saman-fuyal/fpga-audio-filter/docs/photos/setup_raw.jpg

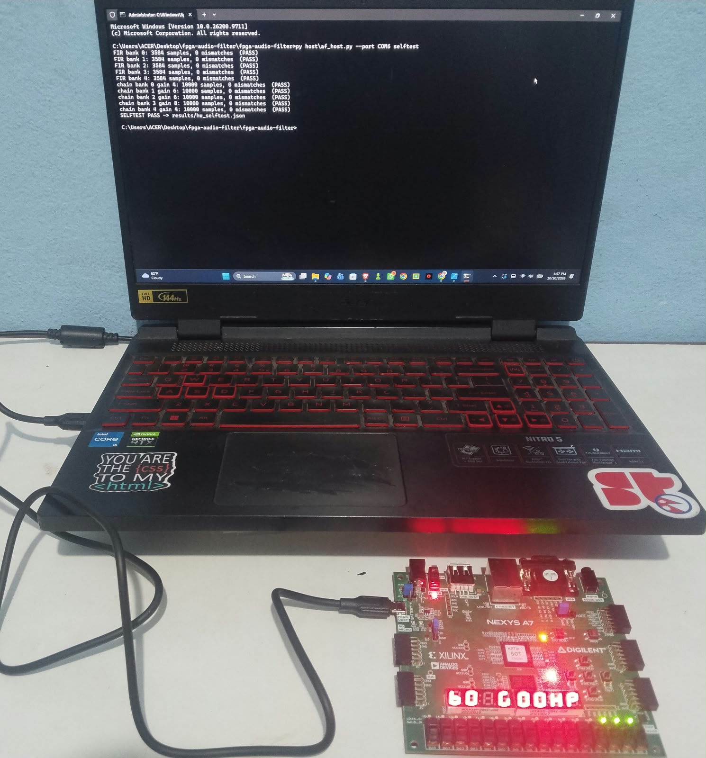
docs/photos/setup_raw.jpg
