saman-fuyal/fpga-audio-filter/docs/photos/setup_labelled.jpg

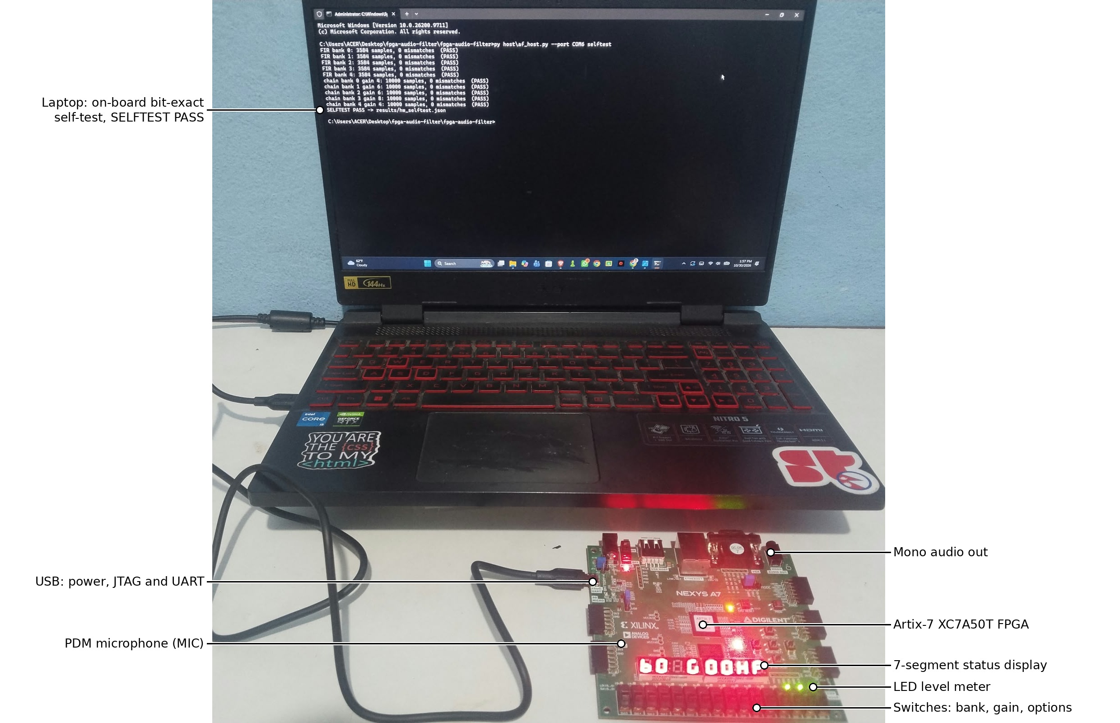
docs/photos/setup_labelled.jpg
