saman-fuyal/fpga-audio-filter/docs/report/figs_src/common.tex

\usepackage[T1]{fontenc}
\usepackage{mathptmx}
\usepackage{tikz}
\usetikzlibrary{arrows.meta,positioning,fit,calc,shapes.geometric,backgrounds}
\usepackage{siunitx}
\tikzset{
  >={Stealth[length=1.8mm]},
  blk/.style={draw, thick, minimum height=11mm, text width=16mm, align=center, font=\scriptsize, inner sep=1.5pt, fill=white},
  lab/.style={font=\scriptsize, align=center},
  every picture/.style={line width=0.6pt},
}
