saman-fuyal/fpga-audio-filter/docs/report/figs/fig_flow.pdf

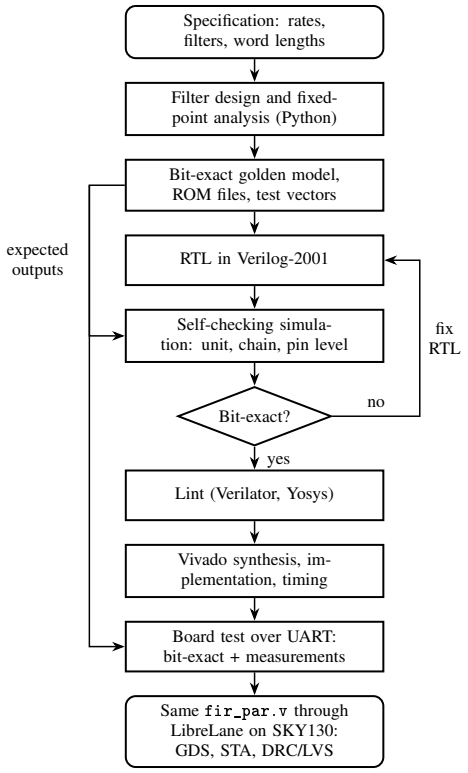
[picture p13: figure]
Specification: rates, filters, word lengths; Filter design and fixed- point analysis (Python); Bit-exact golden model, ROM files, test vectors; RTL in Verilog-2001; Self-checking simula- tion: unit, chain, pin level; Bit-exact?; Lint (Verilator, Yosys); Vivado synthesis, im- plementation, timing; Board test over UART: bit-exact + measurements; Same fir_par.v through LibreLane on SKY130: GDS, STA, DRC/LVS; yes; fix RTL; expected outputs
