saman-fuyal/fpga-audio-filter/docs/report/figs/fig_mac.pdf

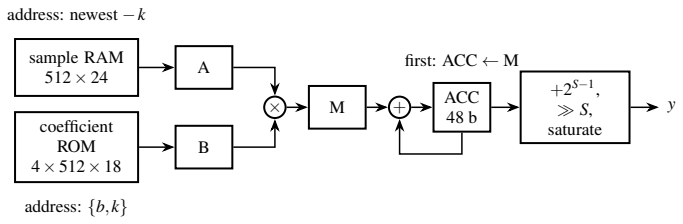
[picture p14: figure]
sample RAM 512; coefficient ROM; ACC 48 b; , saturate; address: newest; address:; first: ACC
