saman-fuyal/fpga-audio-filter/docs/report/figs/fig_system.pdf

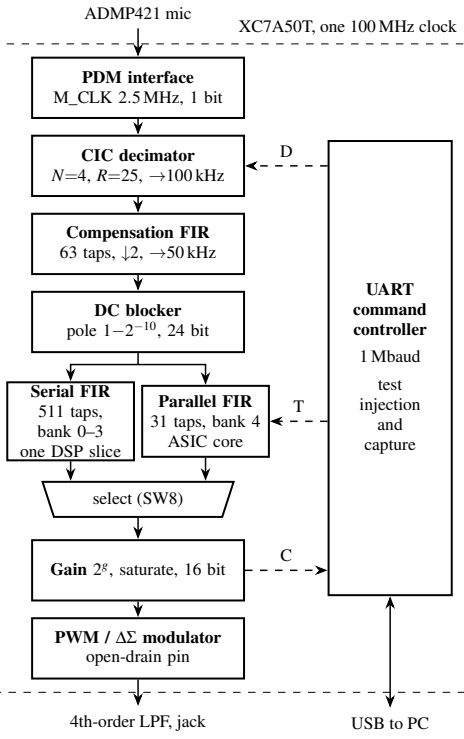
[picture p15: figure]
ADMP421 mic; PDM interface M_CLK 2.5 MHz, 1 bit; CIC decimator N=4, R=25, →100 kHz; Compensation FIR 63 taps, ↓2, →50 kHz; DC blocker pole 1−2; −10, 24 bit; Serial FIR 511 taps, bank 0–3 one DSP slice; Parallel FIR 31 taps, bank 4 ASIC core; select (SW8); Gain 2; , saturate, 16 bit; PWM / ∆Σ modulator open-drain pin; 4th-order LPF, jack; UART command controller; 1 Mbaud; test injection and capture; USB to PC; XC7A50T, one 100 MHz clock
