saman-fuyal/fpga-audio-filter/docs/report/figs/waveforms.pdf

0 | 250 | 500 | 750 | 1000 | 1250 | 1500
Time (ns); dotted = line released (high-Z)

M_CLK

M_DATA

sample strobe

bit to CIC

(a) PDM interface
0 | 1 | 2 | 3 | 4 | 5 | 6
| | | Time (µs)

FIR input strobe

FIR result strobe

FIR state | MAC | IDLE
| 511 MACs = 5110 ns
(b) One output of the 511-tap FIR
