saman-fuyal/fpga-audio-filter/docs/report/figs/user/rtl_dc.pdf

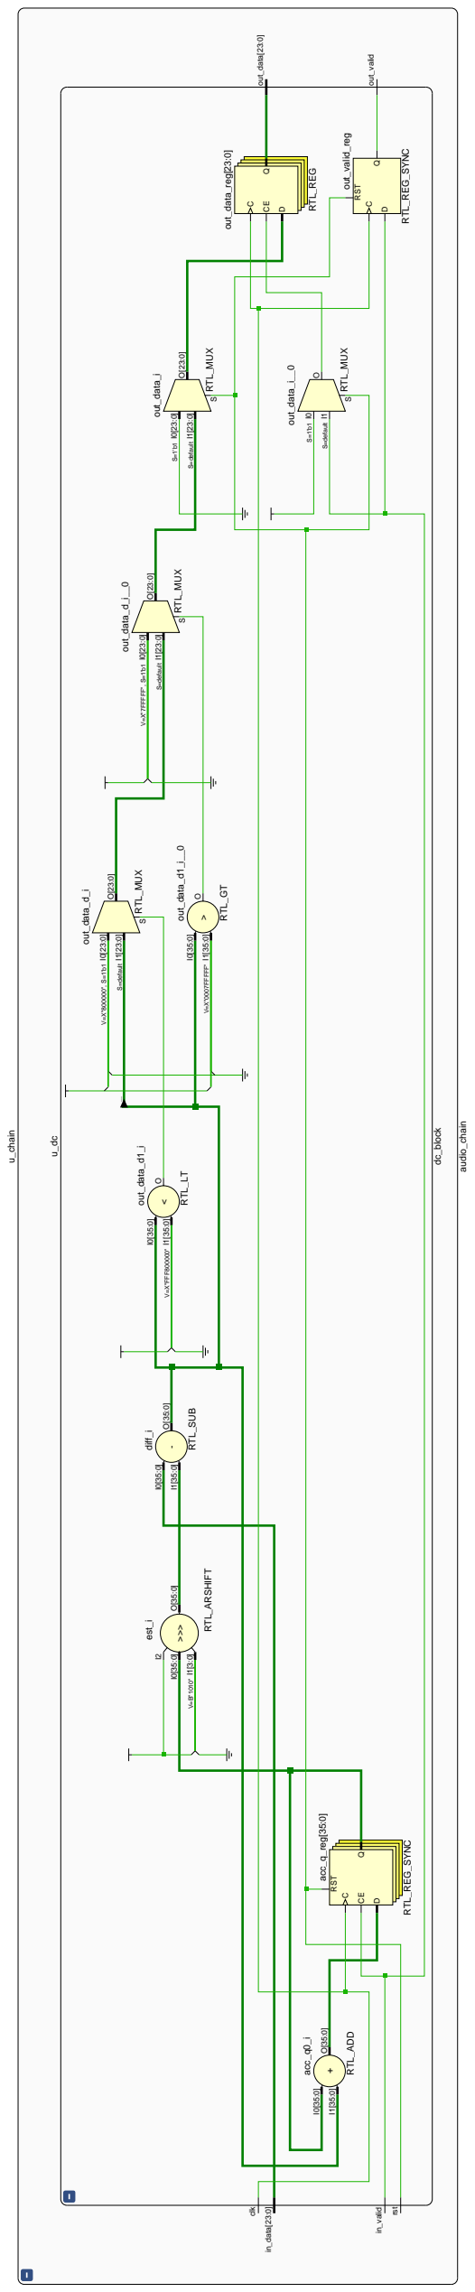
[picture p16: figure]
u_chain; audio_chain; dc_block; clk; in_valid; out_valid; rst; in_data[23:0] out_data[23:0]; acc_q_reg[35:0]; RTL_REG_SYNC; CED; RST; acc_q0_i; RTL_ADD; diff_i; RTL_SUB; est_i; RTL_ARSHIFT; out_data_d_i; RTL_MUX S; I0[23:0] V=X"7FFFFF", S=1'b1; RTL_LT; RTL_GT; I1[35:0] V=X"0007FFFFF"; out_data_i; I1[23:0] S=default O[23:0]; out_data_i__0; RTL_MUX; I1 S=default O; out_data_reg[23:0]; RTL_REG; out_valid_reg

# I1[23:0] S=default O[23:0] out_data_d_i__0

# I1[23:0] S=default O[23:0] out_data_d1_i

# I1[35:0] V=X"FFF800000" out_data_d1_i__0
