saman-fuyal/fpga-audio-filter/docs/report/figs/chain_spectra.png

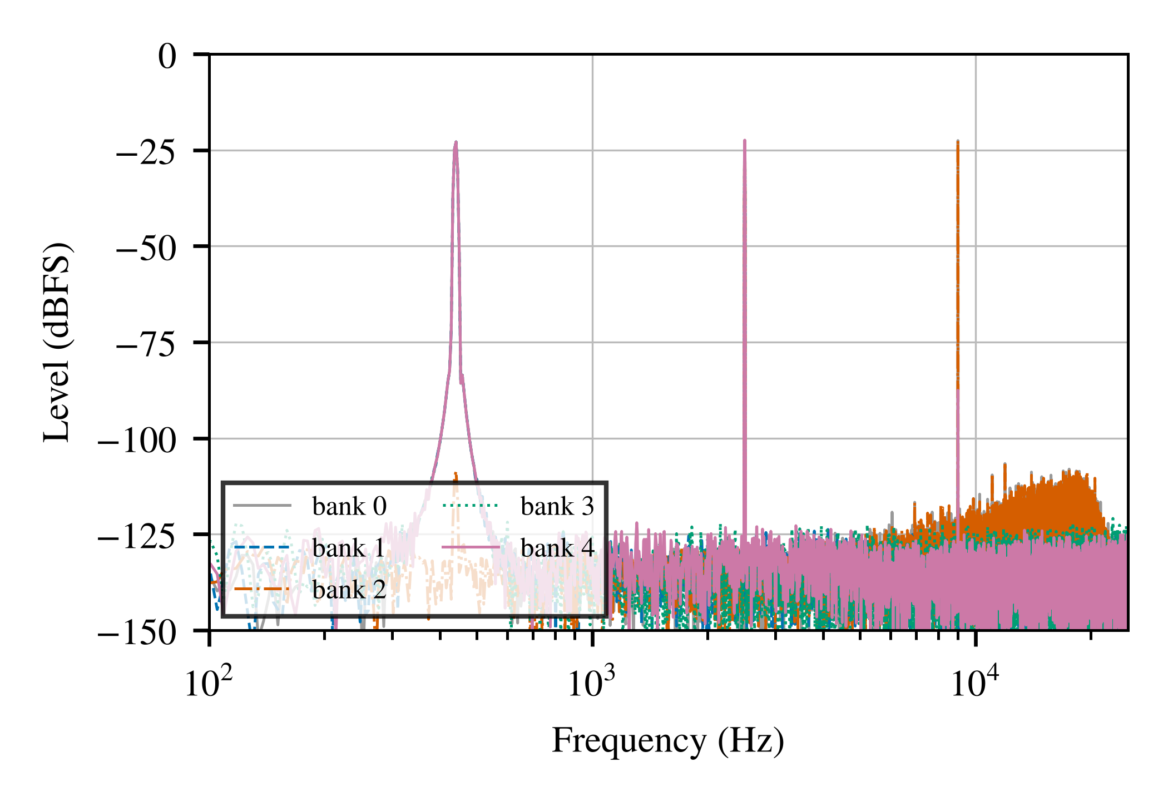
docs/report/figs/chain_spectra.png
