saman-fuyal/fpga-audio-filter/docs/report/figs/droop_comp.png

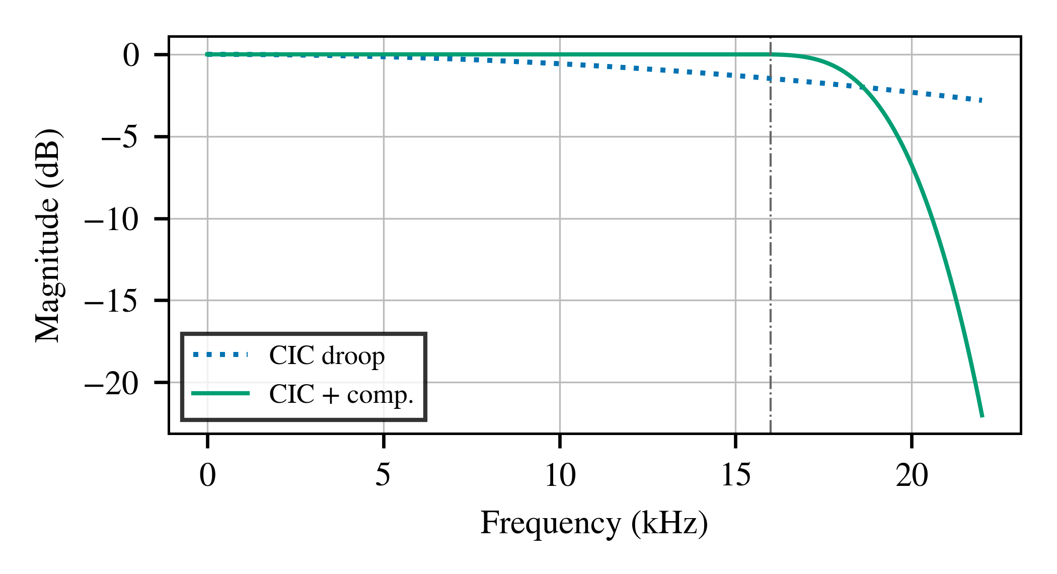
docs/report/figs/droop_comp.png
