saman-fuyal/fpga-audio-filter/docs/report/figs/fig_flow.png

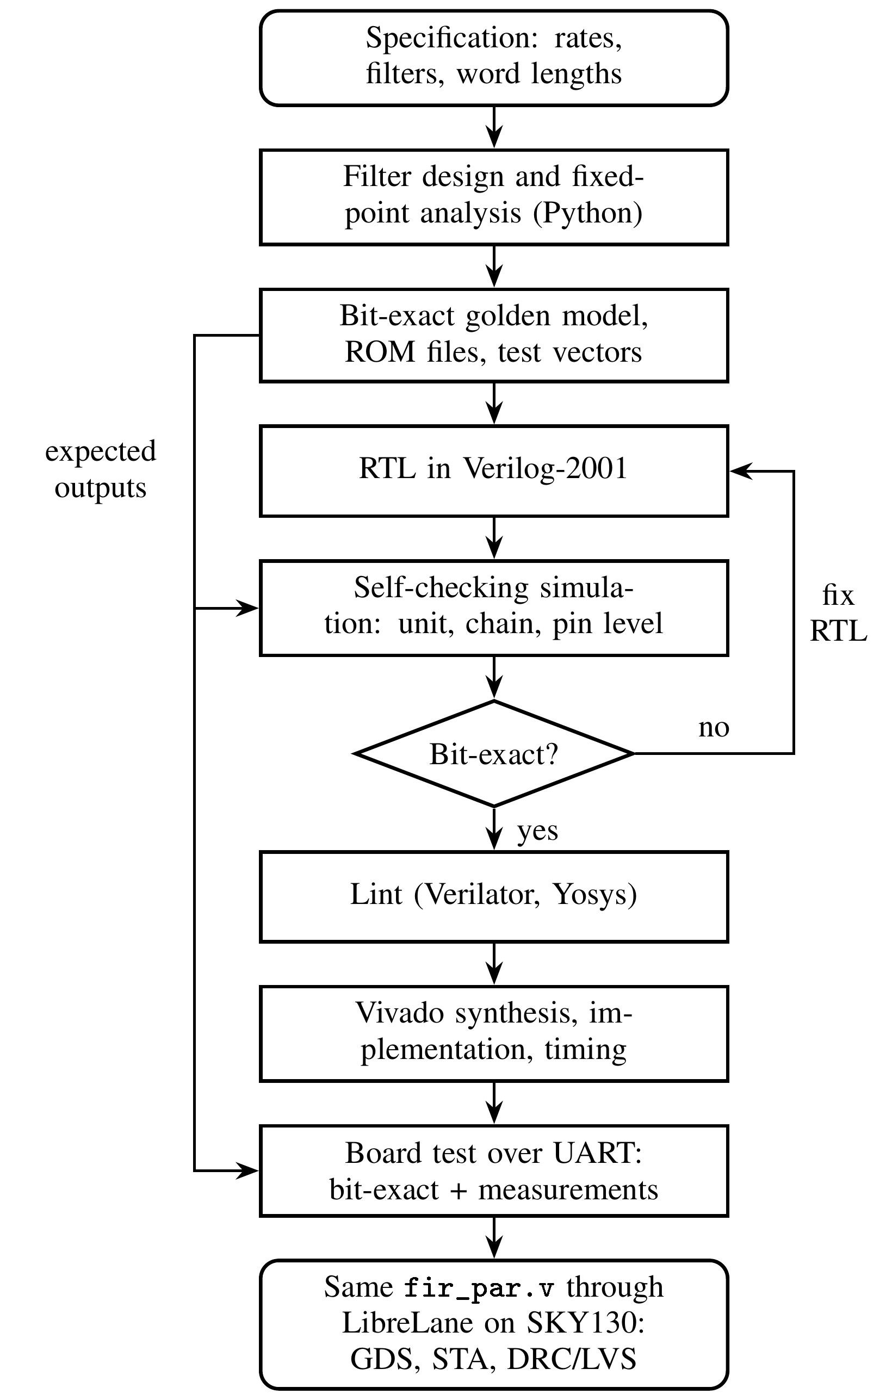
docs/report/figs/fig_flow.png
