saman-fuyal/fpga-audio-filter/docs/report/figs/user/rtl_chain.png

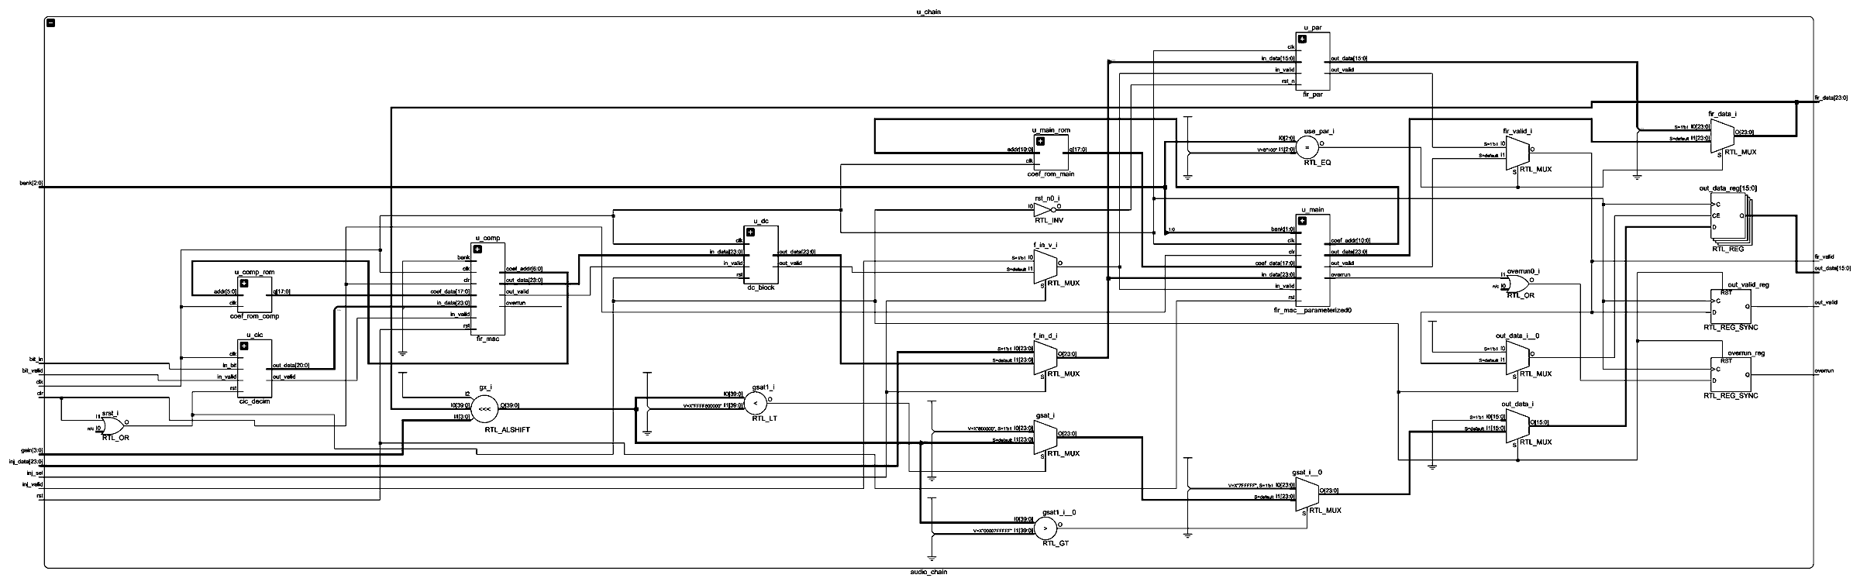
docs/report/figs/user/rtl_chain.png
