saman-fuyal/fpga-audio-filter/docs/report/figs/user/rtl_dc.png

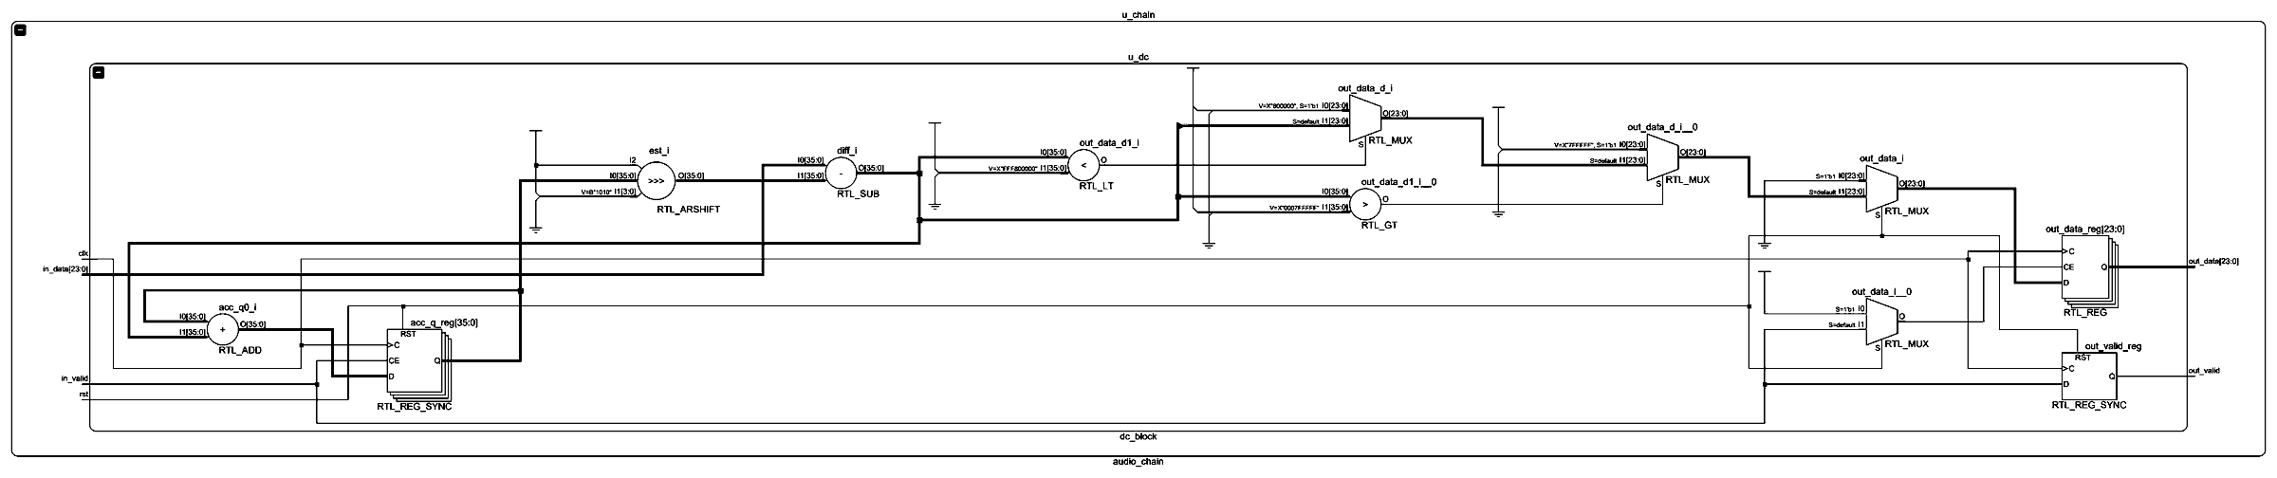
docs/report/figs/user/rtl_dc.png
