saman-fuyal/fpga-audio-filter/docs/report/figs/user/rtl_top.png

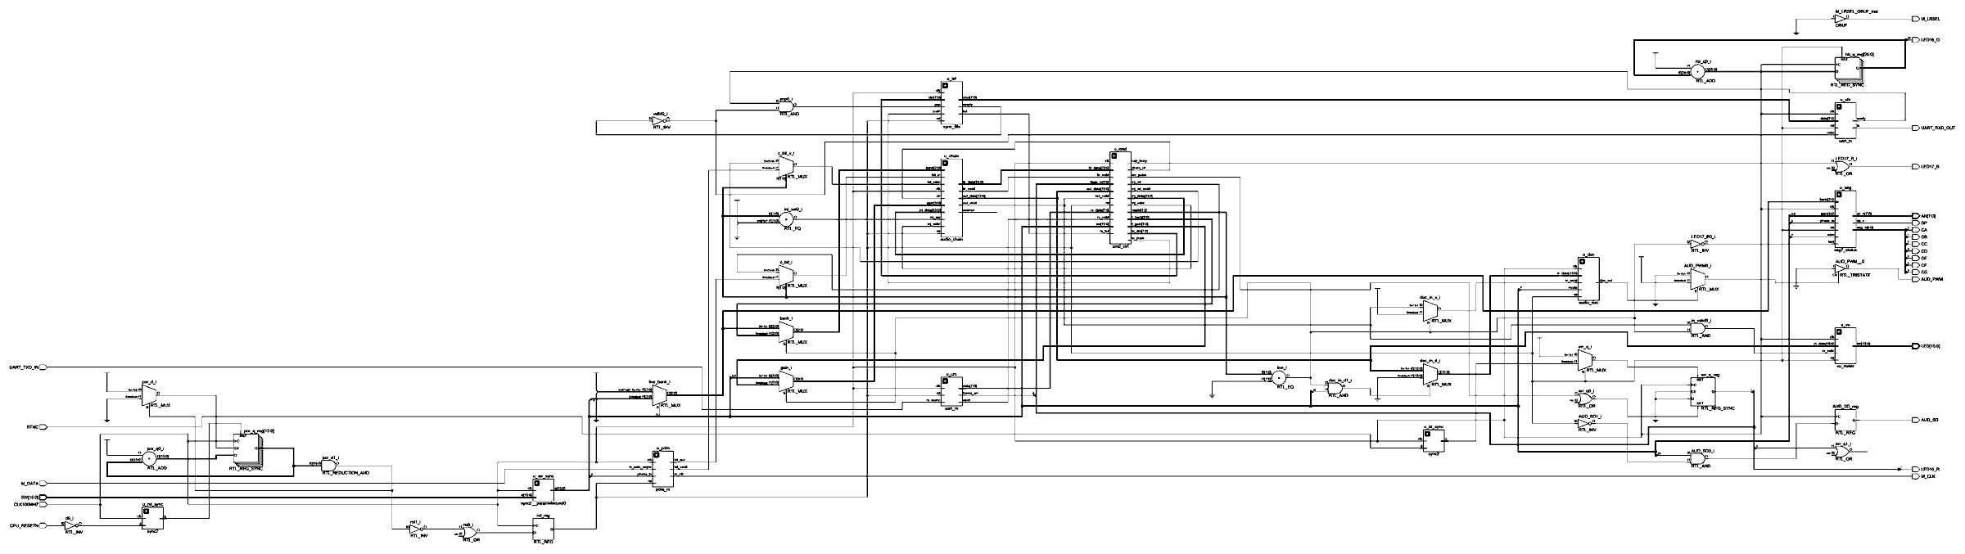
docs/report/figs/user/rtl_top.png
