saman-fuyal/fpga-audio-filter/asic/results/sweep.csv

tag | pipe | period_ns | util | status | design__instance__count | design__instance__area | design__instance__area__stdcell | design__instance__area__class:fill_cell | design__instance__utilization | design__core__area | design__die__area | timing__setup__ws | timing__hold__ws | timing__setup_vio__count | power__total | route__wirelength | clock__skew__worst_setup | magic__drc_error__count | design__lvs_error__count | antenna__violating__nets | fmax_mhz | ws_tt | ws_ss | min_period_tt_ns | gds
p0_t16p0_u45 | 0 | 16.0 | 45 | complete | 58759 | 285209 | 145592 | 139616 | 0.510476 | 285209 | 304283 | -13.86593634713744 | 0.09896661548168303 | 48 | 0.010765722021460533 | 339292 | 0.33345763205631407 | 0 | 0 | 1 | 33.48296160471282 | 0.4057110318091118 | -13.519292734622606 | 15.594288968190888 | fir_par.gds
p0_t25p0_u45 | 0 | 25.0 | 45 | complete | 58759 | 285209 | 145592 | 139616 | 0.510476 | 285209 | 304283 | -4.865937124293579 | 0.09896661548168303 | 48 | 0.00689015444368124 | 339292 | 0.33345763205631407 | 0 | 0 | 1 | 33.48296073343632 | 9.405710254652973 | -4.519293511778745 | 15.594289745347027 | fir_par.gds
p1_t12p0_u45 | 1 | 12.0 | 45 | complete | 67847 | 336863 | 175059 | 161804 | 0.519674 | 336863 | 357450 | -0.7621468116780811 | 0.10048495653310202 | 229 | 0.015835797414183617 | 354230 | 0.32686096421318106 | 0 | 0 | 0 | 78.35672279564625 | 5.36021109337098 | -0.6451399597144462 | 6.63978890662902 | fir_par.gds
p1_t7p0_u45 | 1 | 7.0 | 45 | complete | 64585 | 336863 | 190643 | 146220 | 0.565936 | 336863 | 357450 | -4.452577099717681 | -0.3026921021729397 | 2568 | 0.02745497040450573 | 370707 | 0.32456280248721053 | 0 | 0 | 0 | 87.31659182845851 | 0.9648313532320092 | -4.337702764200058 | 6.035168646767991 | fir_par.gds
