saman-fuyal/fpga-audio-filter/docs/report/results_macros.tex

% GENERATED by docs/report/make_macros.py -- do not edit
\newcommand{\CicDroop}{1.47}
\newcommand{\CompRipple}{0.006}
\newcommand{\CompStop}{95.1}
\newcommand{\CompShift}{2}
\newcommand{\AccBits}{46}
\newcommand{\EndDelay}{5.43}
\newcommand{\ShiftA}{0}
\newcommand{\RippleA}{0.000}
\newcommand{\StopA}{\tbd{--}}
\newcommand{\StopUA}{\tbd{--}}
\newcommand{\StopFA}{\tbd{--}}
\newcommand{\ShiftB}{5}
\newcommand{\RippleB}{0.028}
\newcommand{\StopB}{84.3}
\newcommand{\StopUB}{70.1}
\newcommand{\StopFB}{85.2}
\newcommand{\ShiftC}{1}
\newcommand{\RippleC}{0.023}
\newcommand{\StopC}{77.2}
\newcommand{\StopUC}{70.6}
\newcommand{\StopFC}{88.0}
\newcommand{\ShiftD}{3}
\newcommand{\RippleD}{0.035}
\newcommand{\StopD}{79.3}
\newcommand{\StopUD}{69.3}
\newcommand{\StopFD}{83.2}
\newcommand{\SimCic}{PASS}
\newcommand{\SimFir}{PASS}
\newcommand{\SimChain}{PASS}
\newcommand{\SimTop}{PASS}
\newcommand{\YLut}{2{,}173}
\newcommand{\YFf}{2{,}274}
\newcommand{\YDsp}{18}
\newcommand{\YBram}{10.5}
\newcommand{\YLutram}{0}
\newcommand{\VLut}{1{,}948}
\newcommand{\VFf}{2{,}191}
\newcommand{\VDsp}{18}
\newcommand{\VBram}{10.5}
\newcommand{\VWns}{1.462}
\newcommand{\VWhs}{0.048}
\newcommand{\VFmax}{117.1}
\newcommand{\VPower}{95}
\newcommand{\VDynPower}{33}
\newcommand{\HwFirSamples}{17{,}920}
\newcommand{\HwFirErr}{0}
\newcommand{\HwChainSamples}{50{,}000}
\newcommand{\HwChainErr}{0}
\newcommand{\HwSnr}{42.2}
\newcommand{\HwThd}{-37.6}
\newcommand{\HwSinad}{36.3}
\newcommand{\HwTone}{1001}
\newcommand{\HaveHwFreq}{1}
\newcommand{\HaveHwCapture}{1}
\newcommand{\AsicStop}{53.7}
\newcommand{\AsicCsd}{67}
\newcommand{\EAreaZ}{85840}
\newcommand{\ECellsZ}{10{,}393}
\newcommand{\EFlopsZ}{514}
\newcommand{\EDelayZ}{14.38}
\newcommand{\EFmaxZ}{70}
\newcommand{\EAreaO}{100199}
\newcommand{\ECellsO}{11{,}862}
\newcommand{\EFlopsO}{1{,}677}
\newcommand{\EDelayO}{5.74}
\newcommand{\EFmaxO}{174}
\newcommand{\HaveSweep}{0}
\newcommand{\LPeriodZ}{\tbd{TBD}}
\newcommand{\LAreaZ}{\tbd{TBD}}
\newcommand{\LPowerZ}{\tbd{TBD}}
\newcommand{\LDrcZ}{\tbd{TBD}}
\newcommand{\LLvsZ}{\tbd{TBD}}
\newcommand{\LPeriodO}{\tbd{TBD}}
\newcommand{\LAreaO}{\tbd{TBD}}
\newcommand{\LPowerO}{\tbd{TBD}}
\newcommand{\LDrcO}{\tbd{TBD}}
\newcommand{\LLvsO}{\tbd{TBD}}
