saman-fuyal/fpga-audio-filter/asic/results/asic_sweep.pdf

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

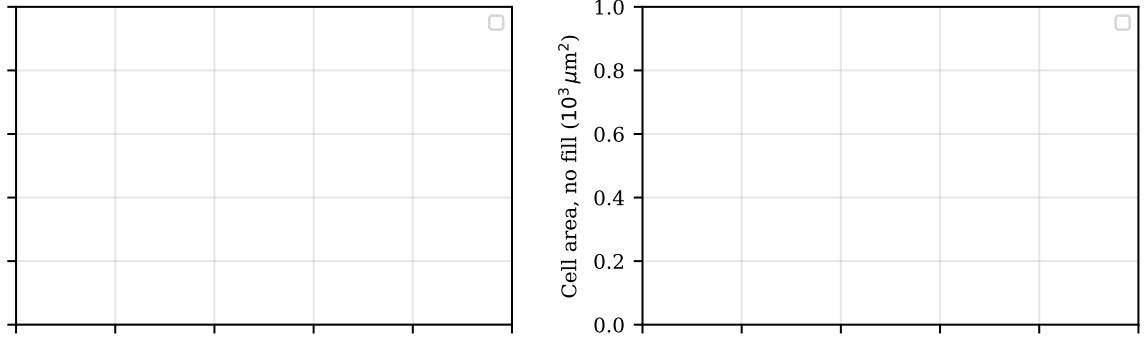
[picture p23: figure]
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
