saman-fuyal/fpga-audio-filter/asic/results/asic_sweep.png

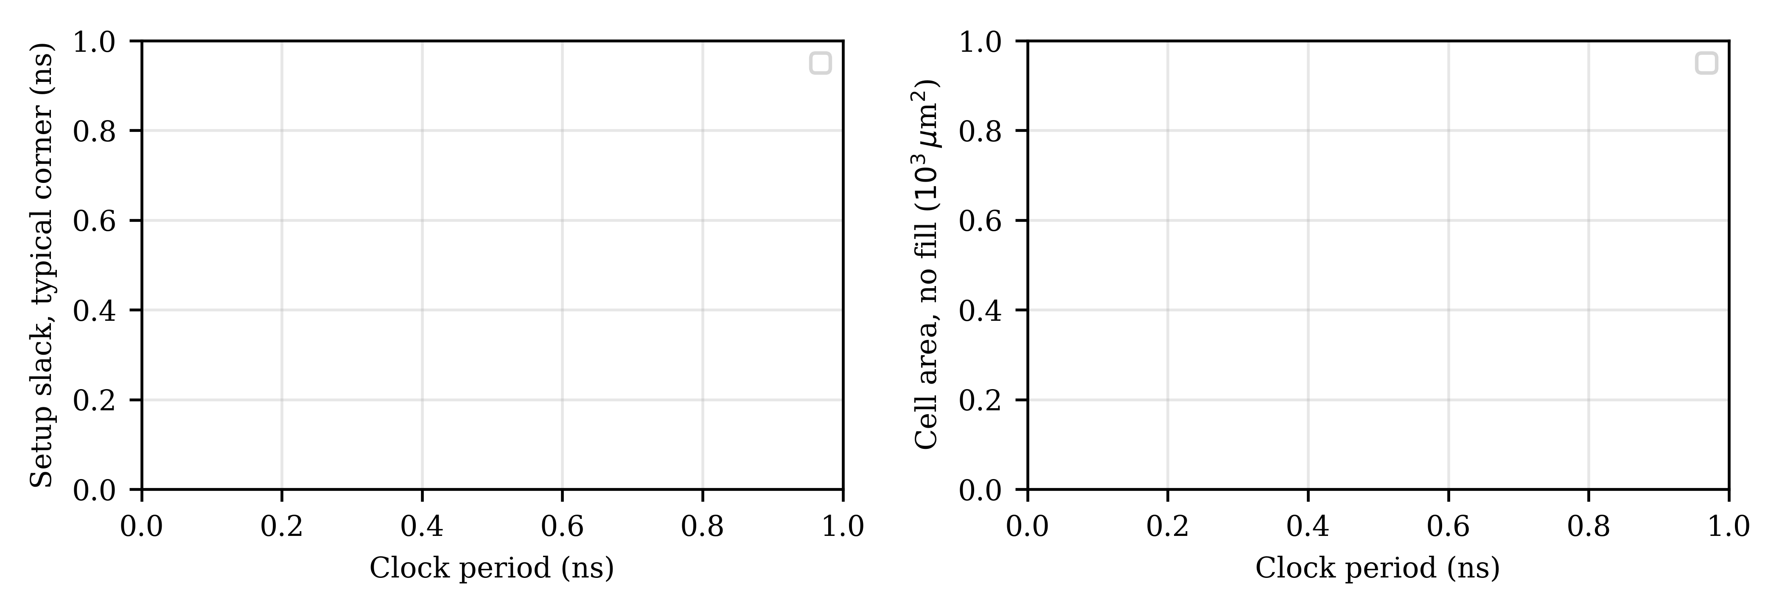
asic/results/asic_sweep.png
