saman-fuyal/fpga-audio-filter/results/hw_freqresp_b0.png

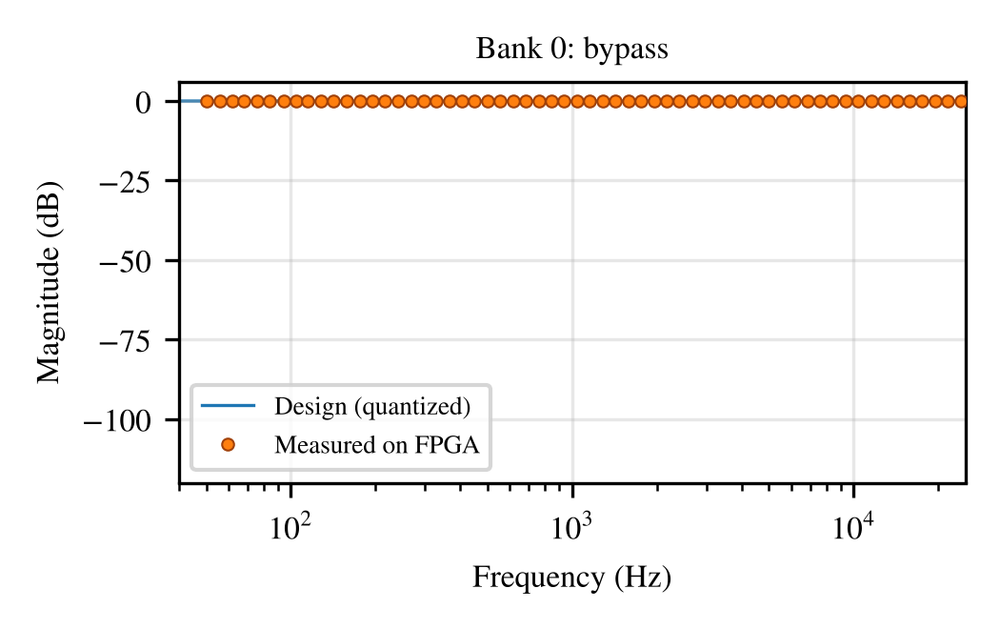
results/hw_freqresp_b0.png
