saman-fuyal/fpga-audio-filter/results/hw_freqresp_b1.png

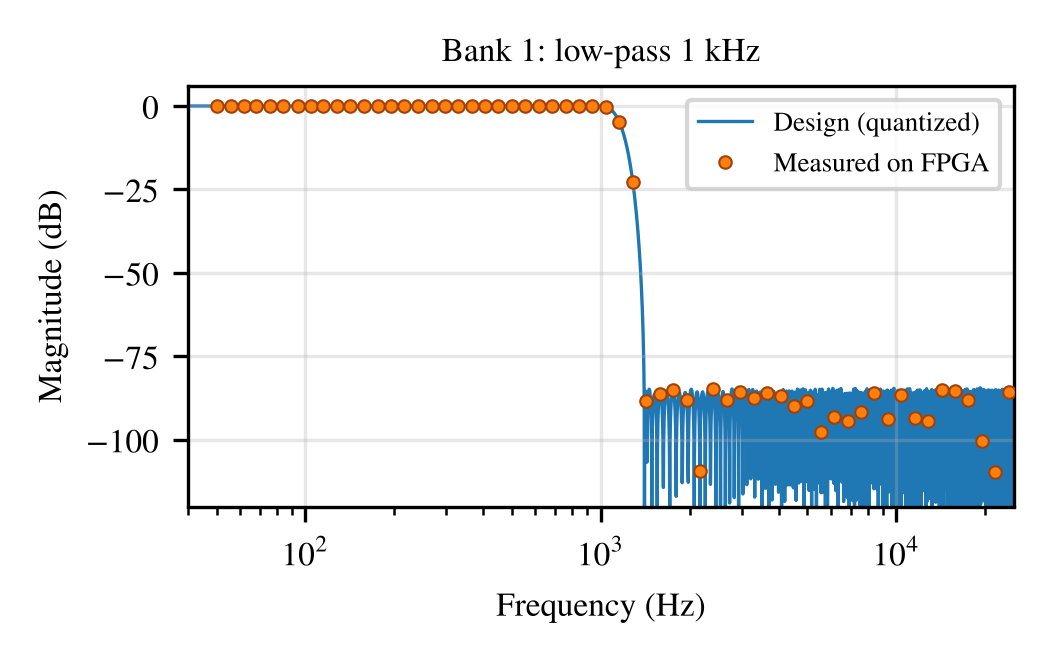
results/hw_freqresp_b1.png
