saman-fuyal/fpga-audio-filter/results/hw_freqresp_b2.png

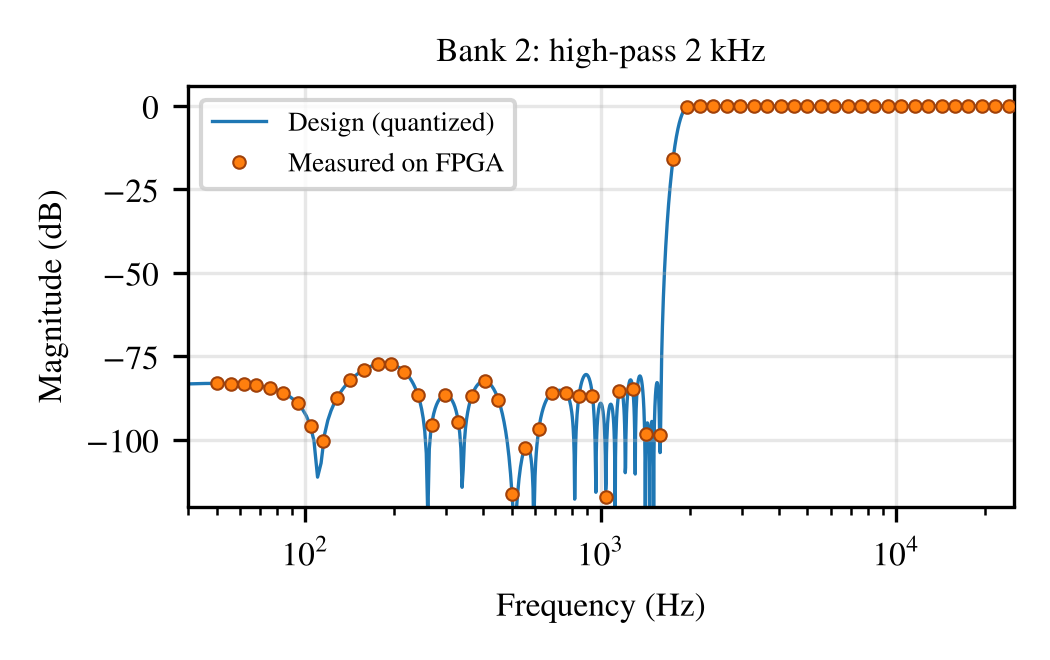
results/hw_freqresp_b2.png
