saman-fuyal/fpga-audio-filter/results/hw_freqresp_b3.png

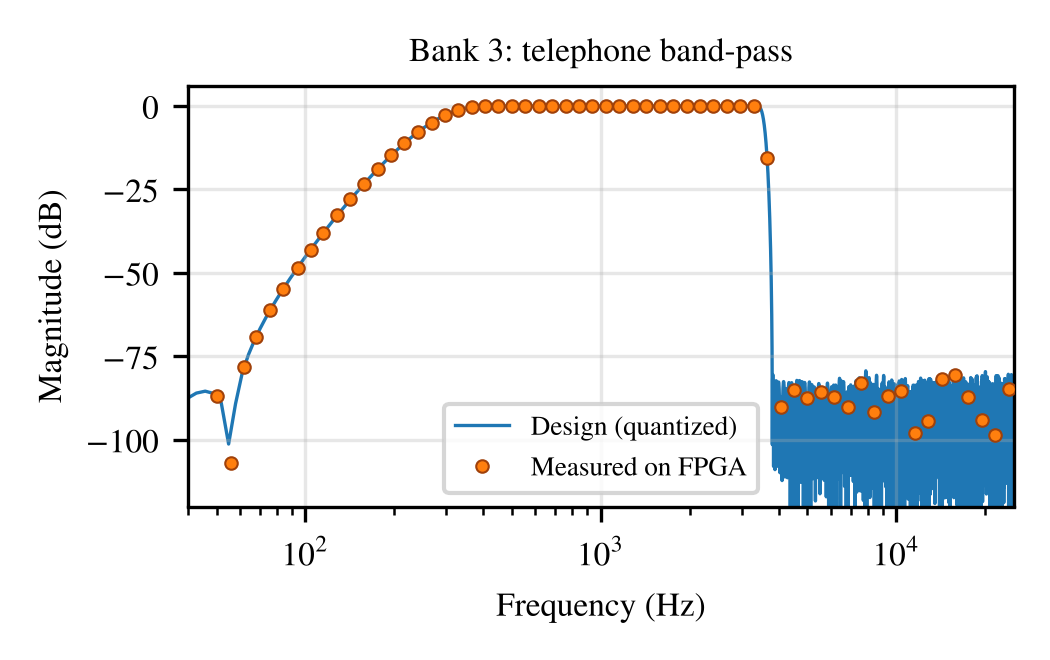
results/hw_freqresp_b3.png
