saman-fuyal/fpga-audio-filter/results/hw_freqresp_b4.png

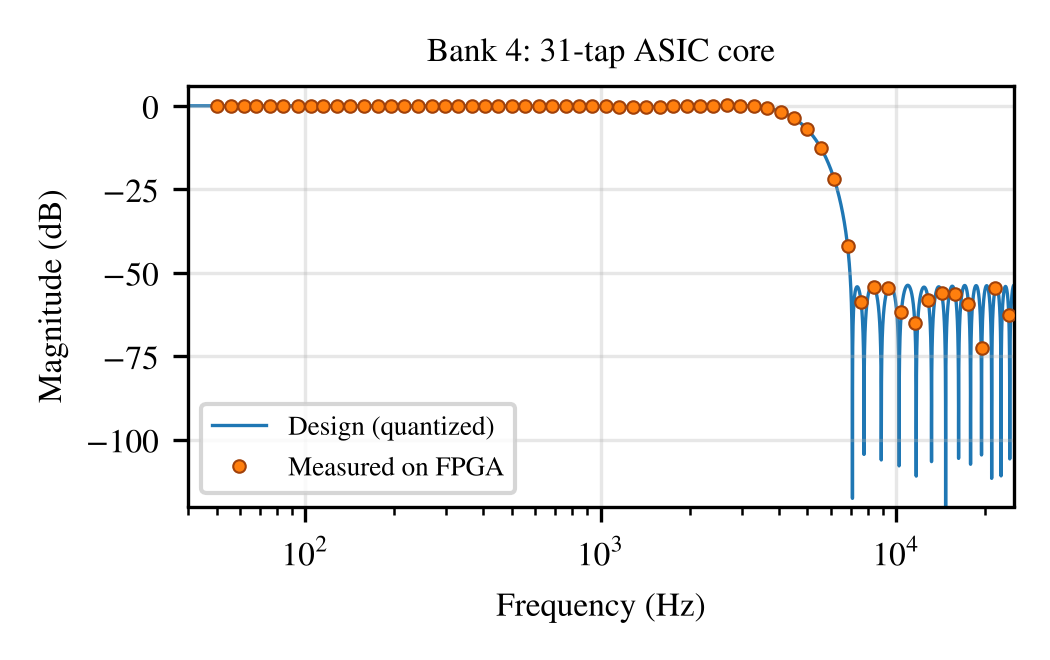
results/hw_freqresp_b4.png
