saman-fuyal/fpga-audio-filter/results/hw_voice.png

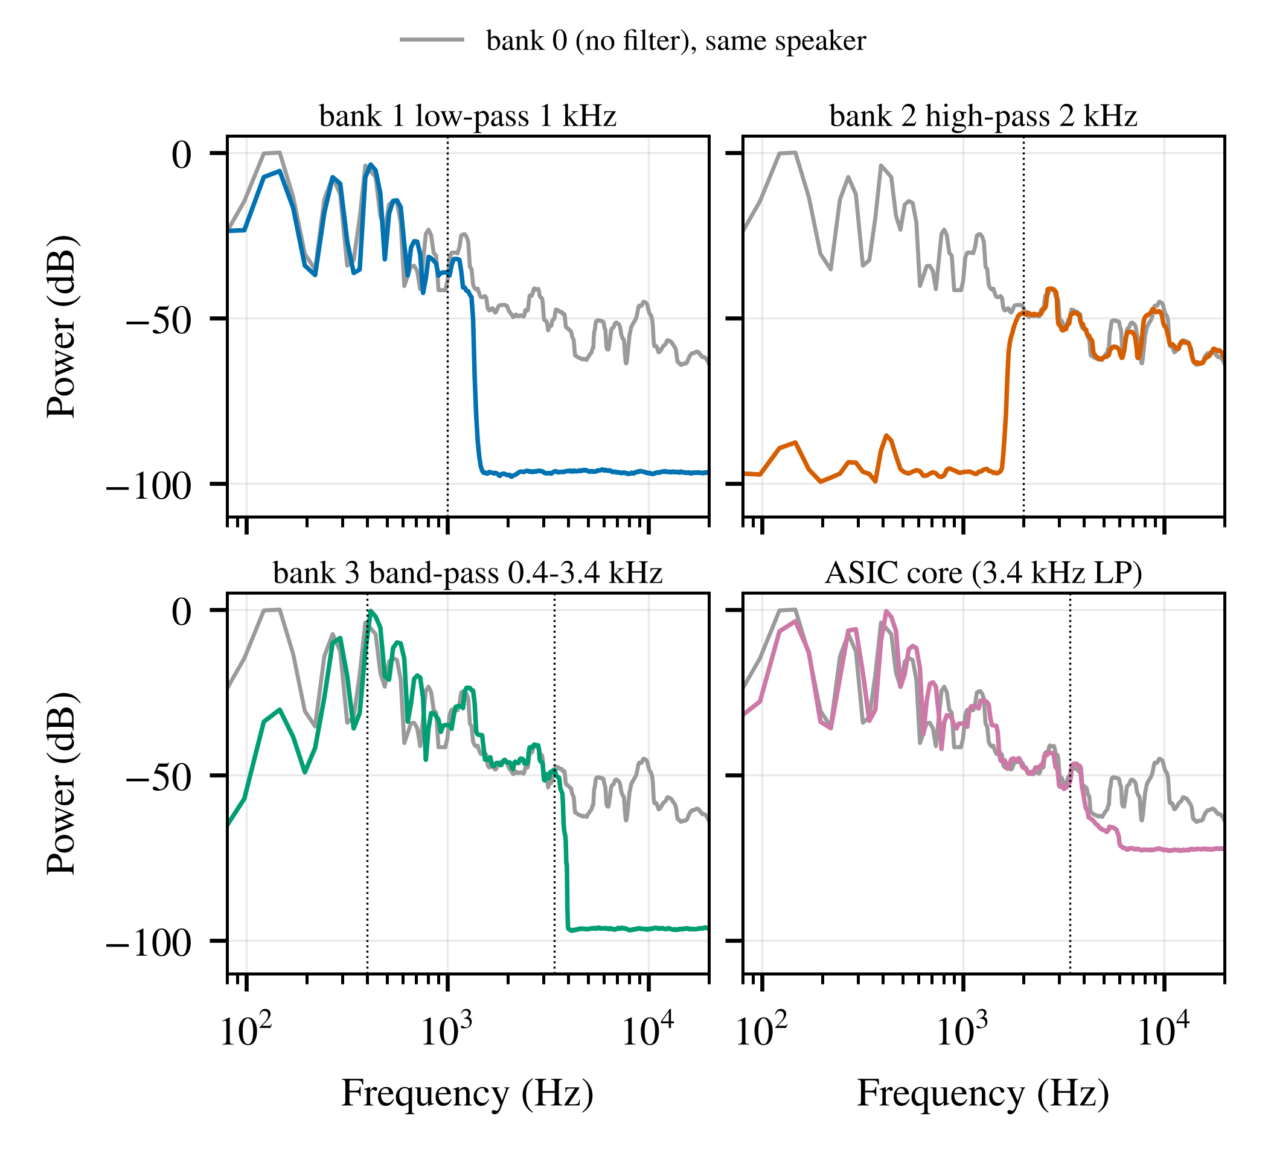
results/hw_voice.png
