saman-fuyal/fpga-audio-filter/results/hw_voice.pdf

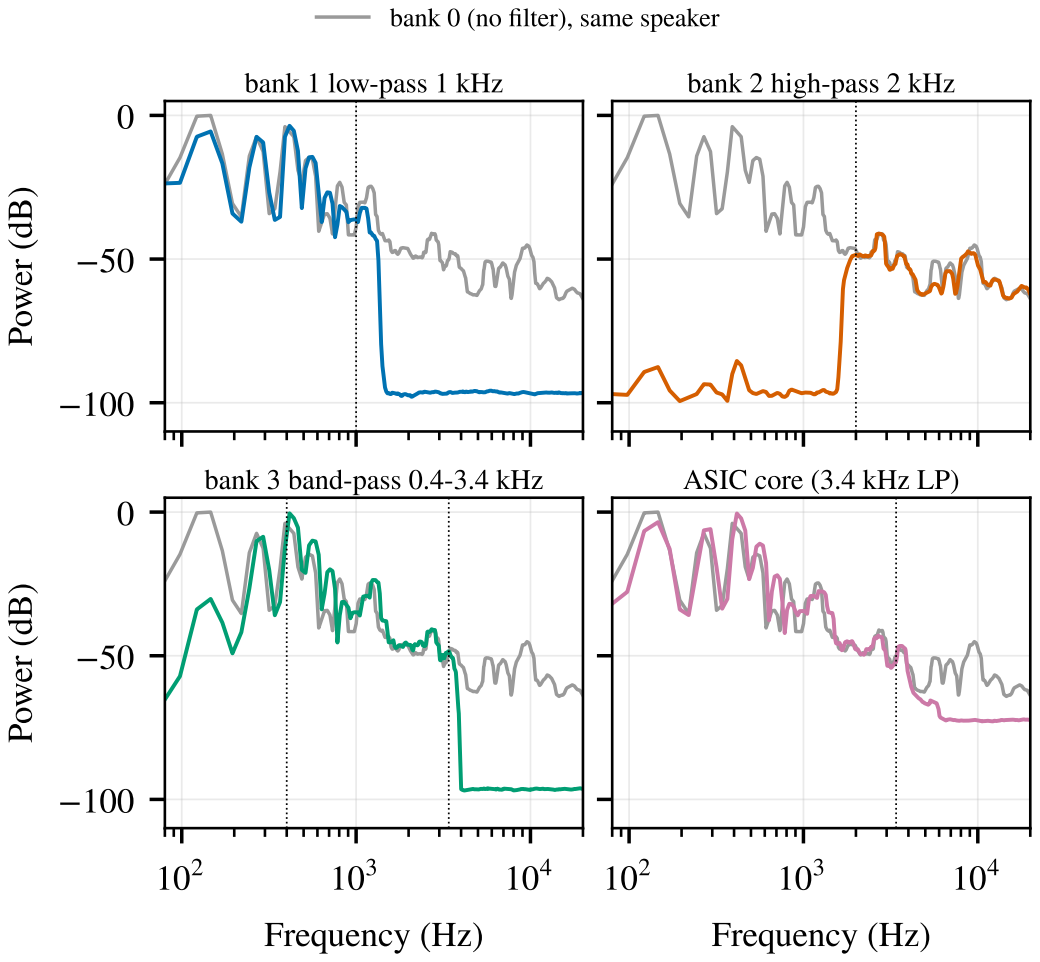
[picture p31: page 1]
Power (dB); bank 1 low-pass 1 kHz; bank 2 high-pass 2 kHz; Frequency (Hz)

bank 0 (no filter), same speaker

bank 3 band-pass 0.4-3.4 kHz

ASIC core (3.4 kHz LP)
