saman-fuyal/fpga-audio-filter/docs/report/figs/bitexact.pdf

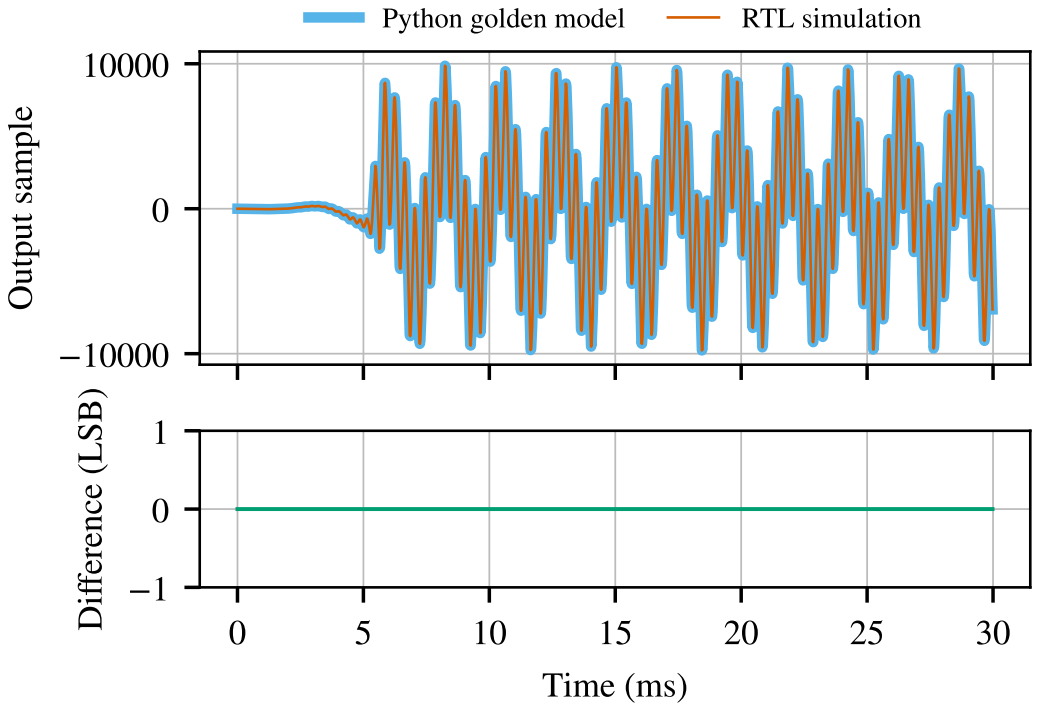
[picture p32: page 1]
Output sample; Python golden model; RTL simulation; Time (ms); Difference (LSB)
