saman-fuyal/fpga-audio-filter/docs/report/figs/fig_fsm.pdf

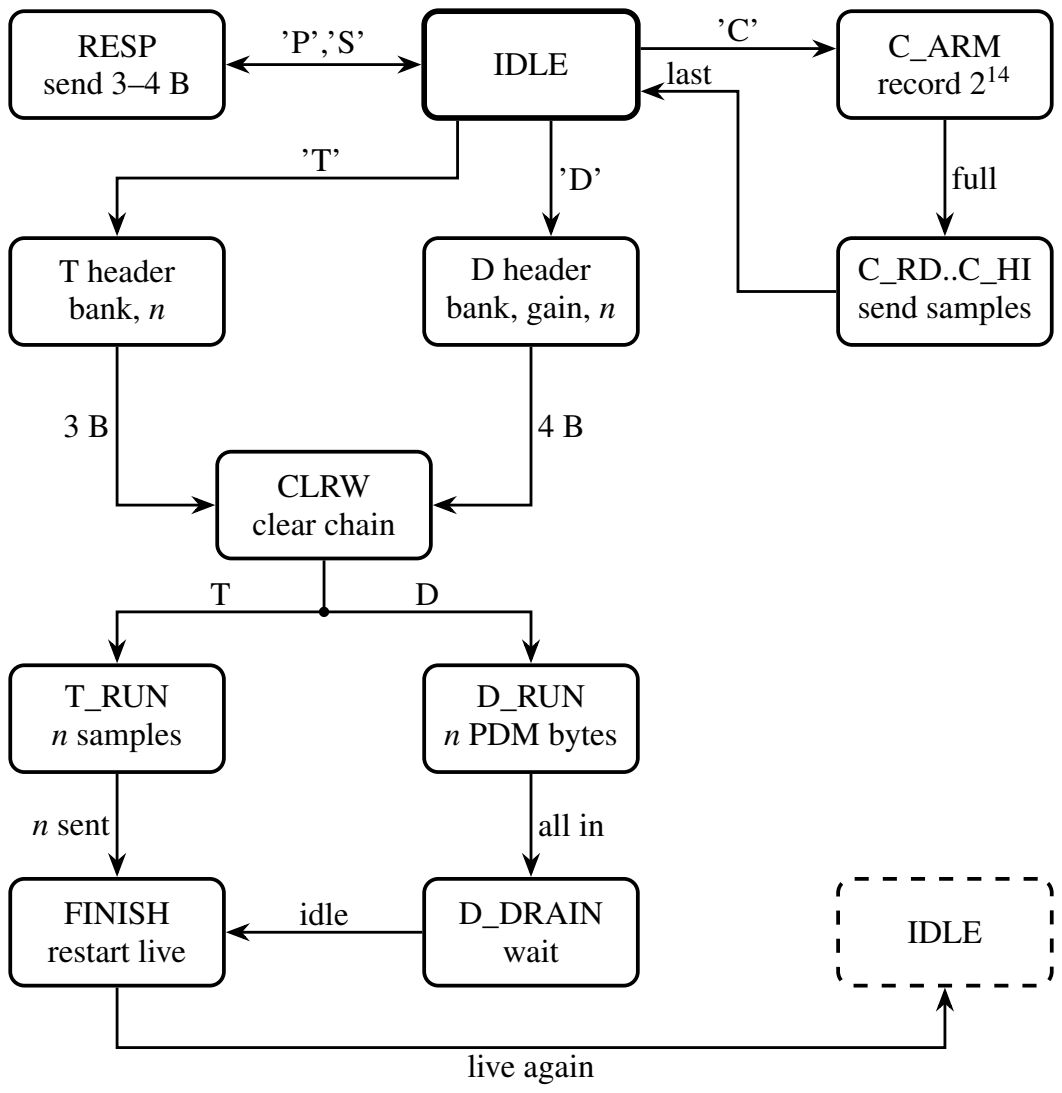
[picture p33: page 1]
RESP; send 3–4 B; IDLE; C_ARM; record 2¹⁴; T header bank, n; D header bank, gain, n; C_RD..C_HI send samples; CLRW clear chain; T_RUN n samples; D_RUN n PDM bytes; FINISH restart live; D_DRAIN; wait; full; last; n sent; all in; idle; live again
