saman-fuyal/fpga-audio-filter/results/hw_d4b_v6.pdf

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

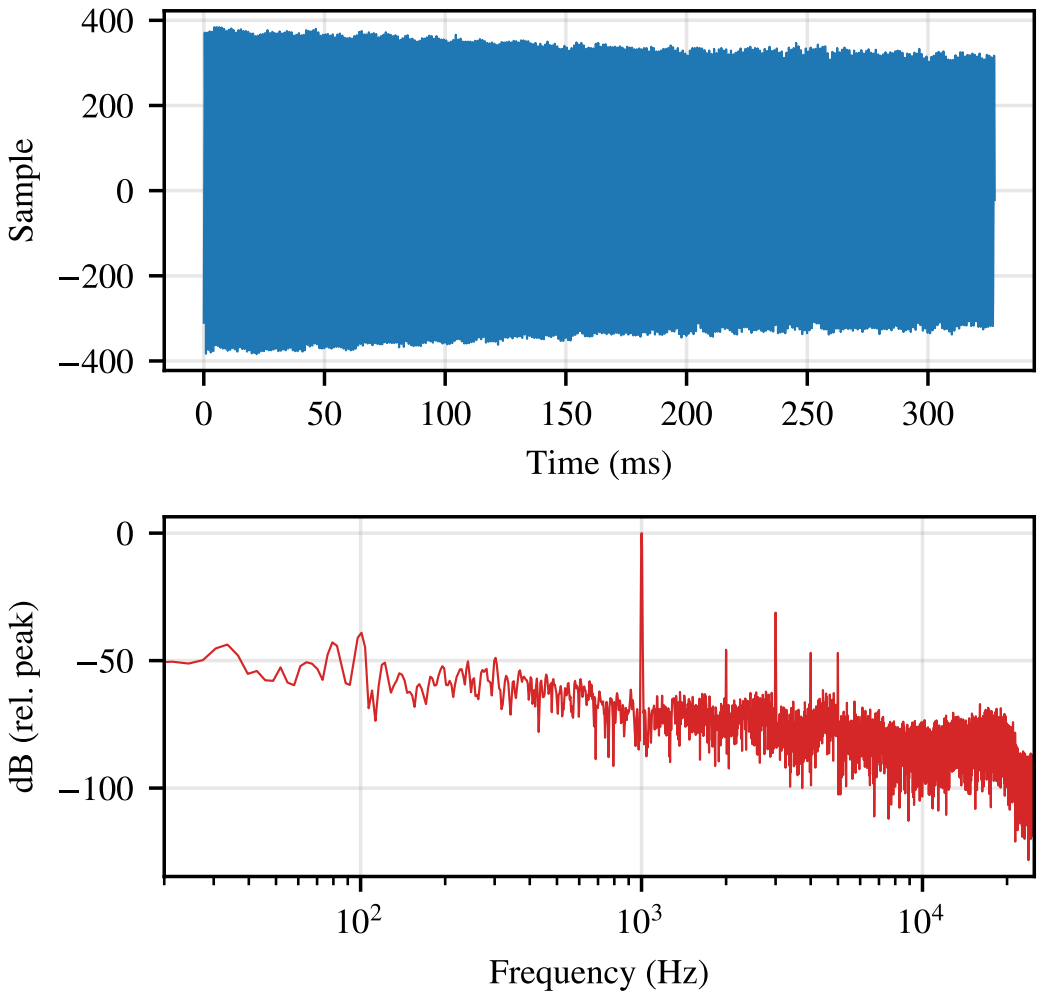
[picture p36: page 1]
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
