saman-fuyal/fpga-audio-filter/results/hw_d8_on_1k.pdf

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

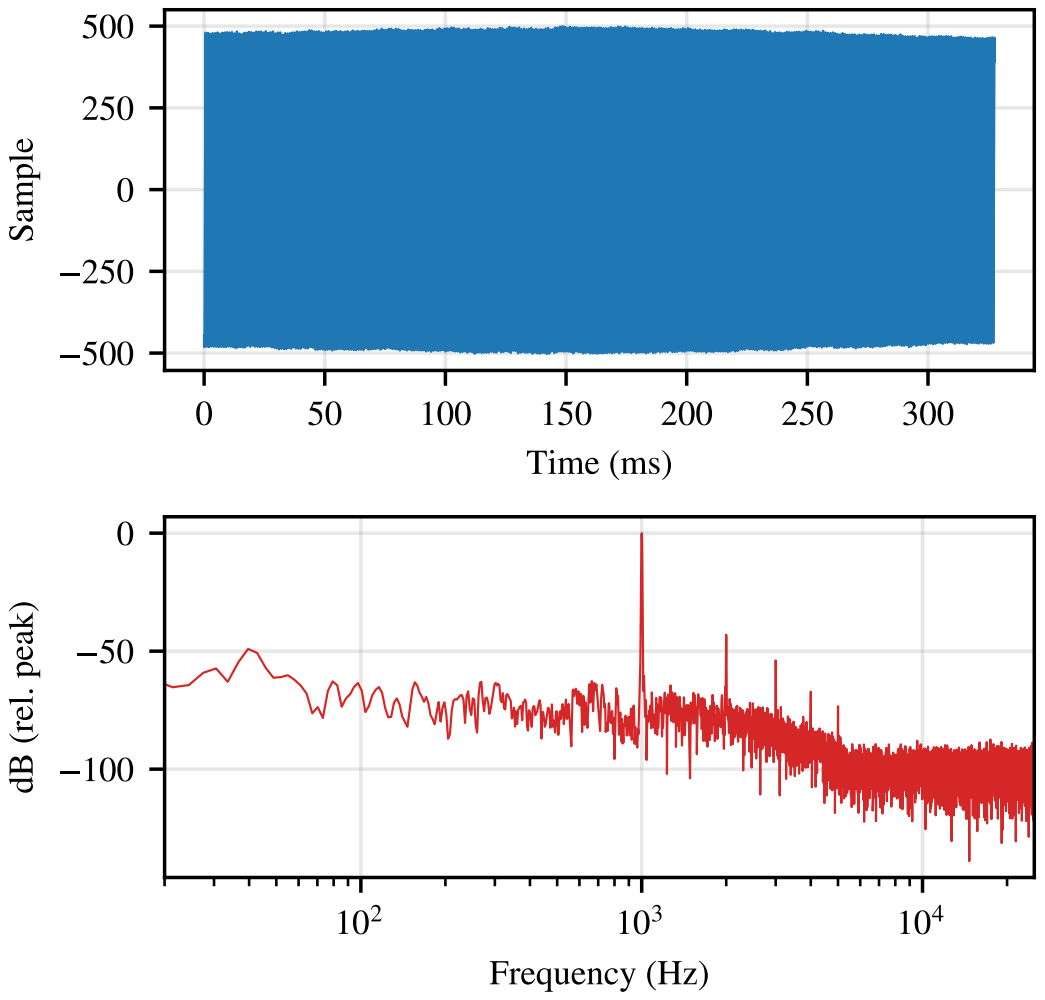
[picture p45: page 1]
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
