saman-fuyal/fpga-audio-filter/results/hw_d8_on_8k.pdf

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

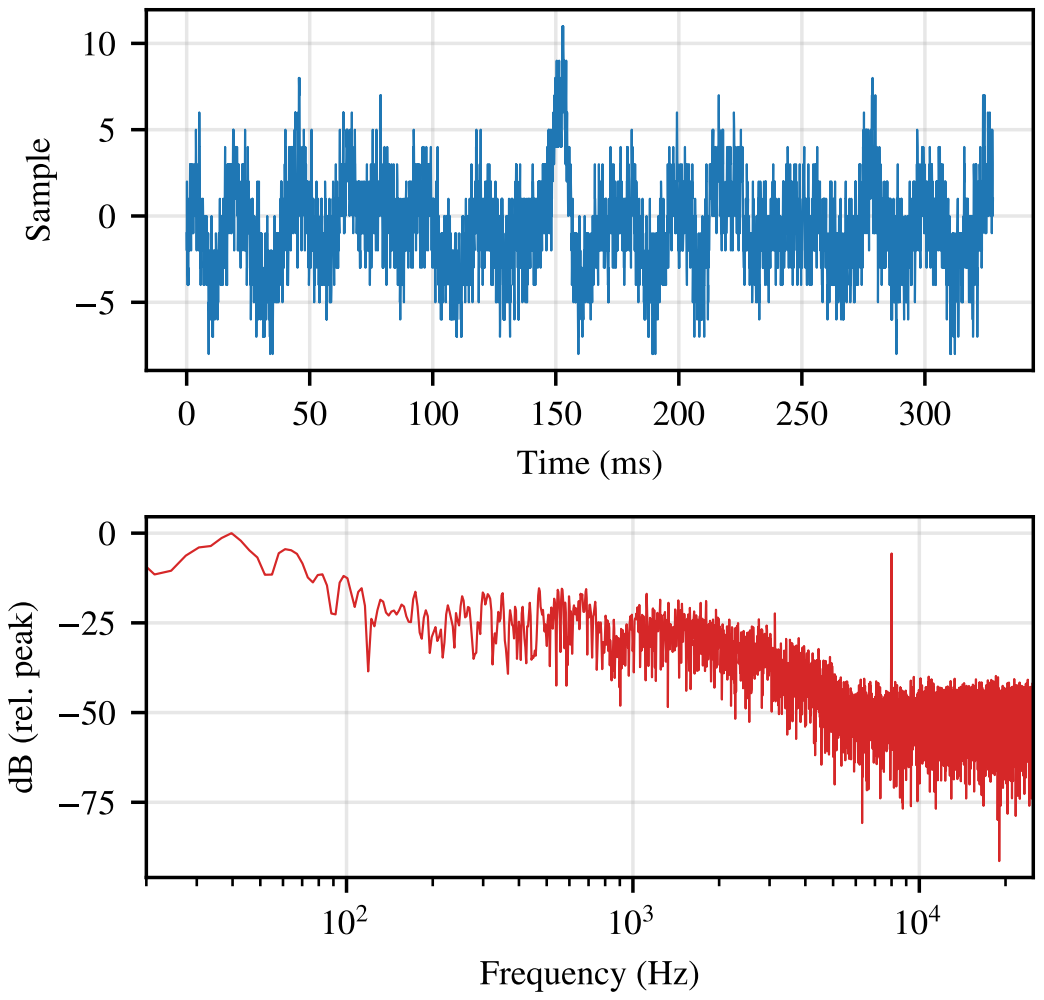
[picture p46: page 1]
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
