saman-fuyal/fpga-audio-filter/results/hw_freqresp_b0.pdf

−100 −75 −50 −250

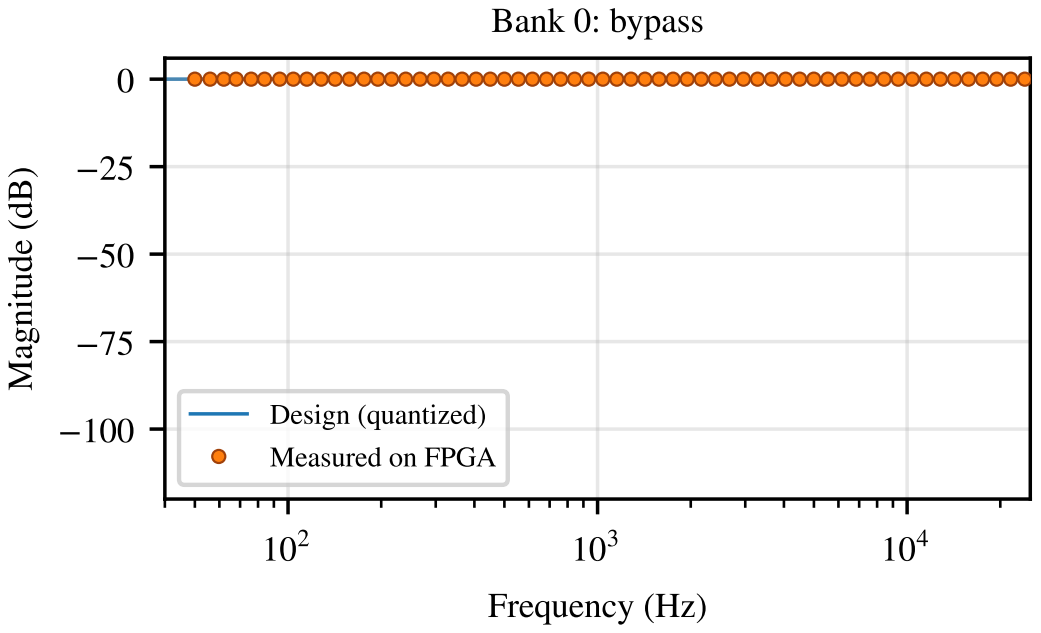
[picture p47: page 1]
Frequency (Hz); Magnitude (dB); Bank 0: bypass

Design (quantized)
Measured on FPGA
