saman-fuyal/fpga-audio-filter/results/hw_freqresp_b1.pdf

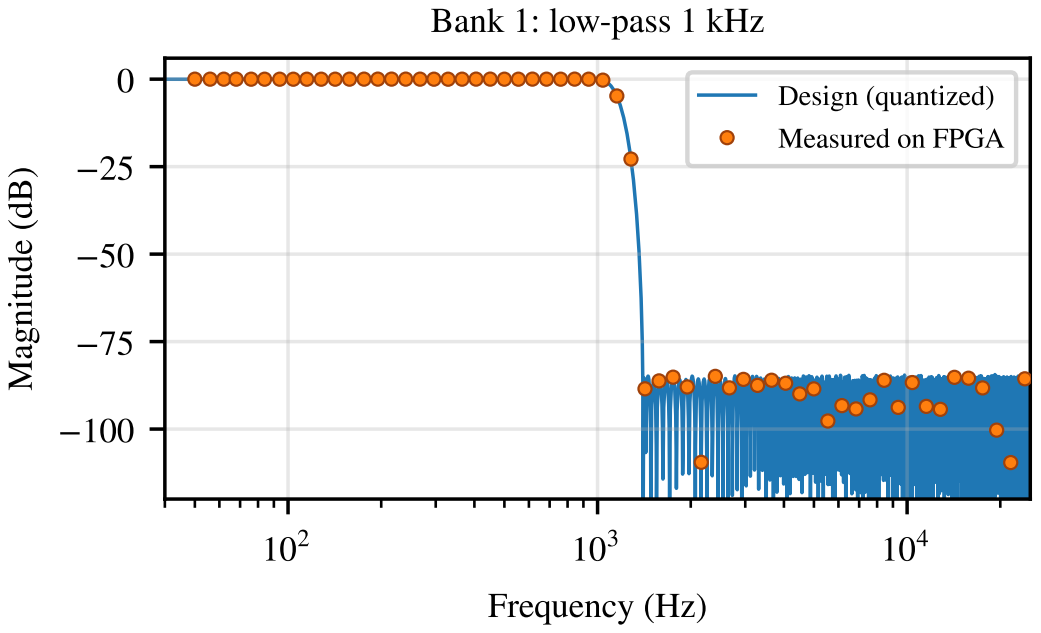
[picture p48: page 1]
Frequency (Hz); Magnitude (dB)

Bank 1: low-pass 1 kHz

Design (quantized)
Measured on FPGA
