saman-fuyal/fpga-audio-filter/results/hw_freqresp_b2.pdf

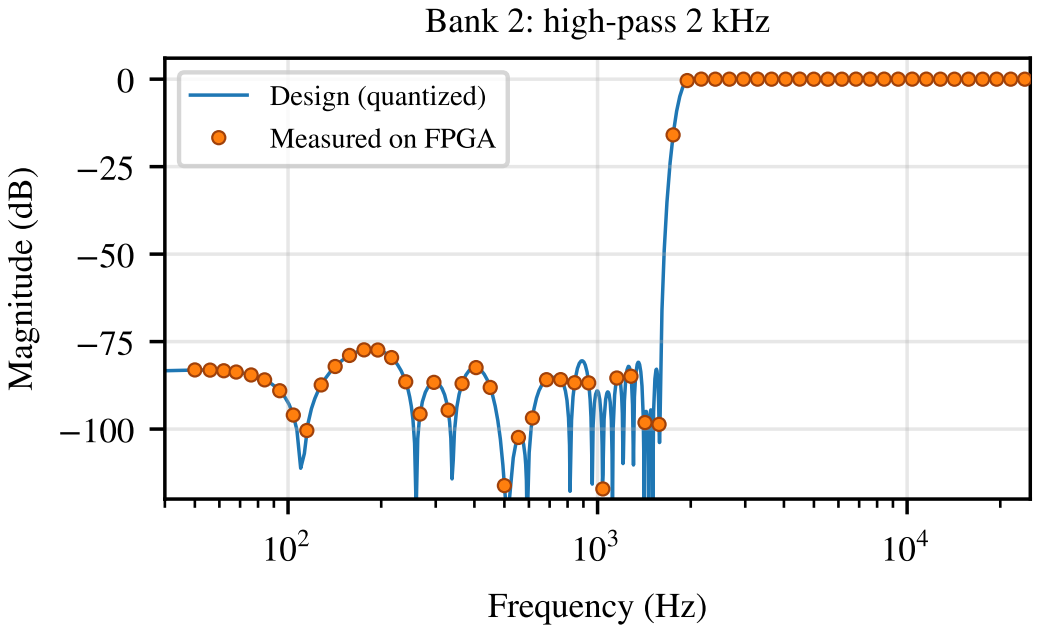
[picture p49: page 1]
Frequency (Hz); Magnitude (dB)

Bank 2: high-pass 2 kHz

Design (quantized)
Measured on FPGA
