saman-fuyal/fpga-audio-filter/results/hw_freqresp_b3.pdf

−100 −75 −50 −250

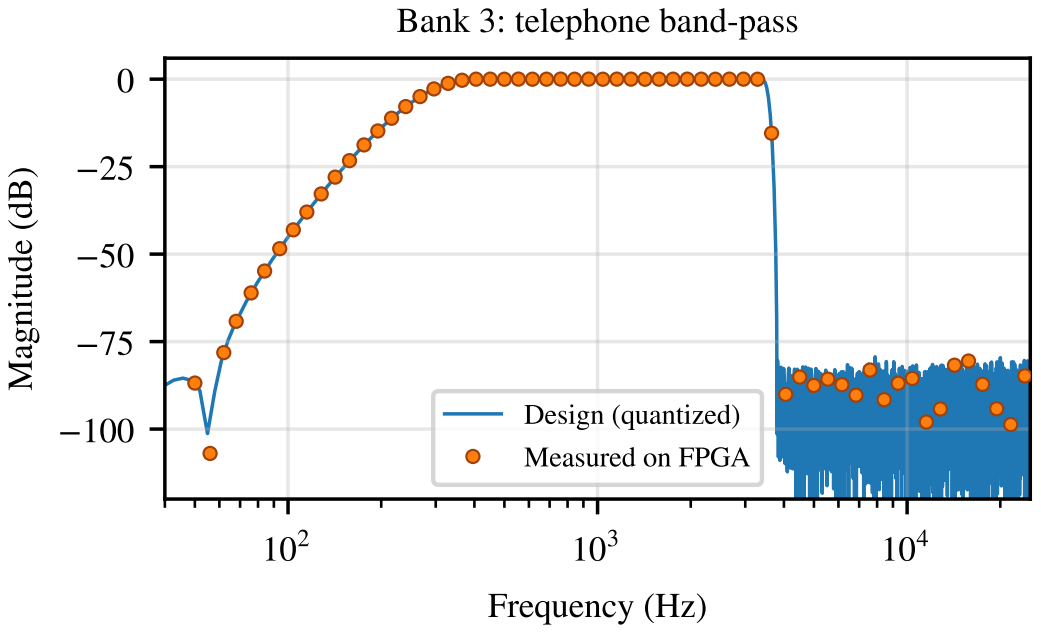
[picture p50: page 1]
Frequency (Hz); Magnitude (dB)

Bank 3: telephone band-pass

Design (quantized)
Measured on FPGA
