saman-fuyal/fpga-audio-filter/results/hw_freqresp_b4.pdf

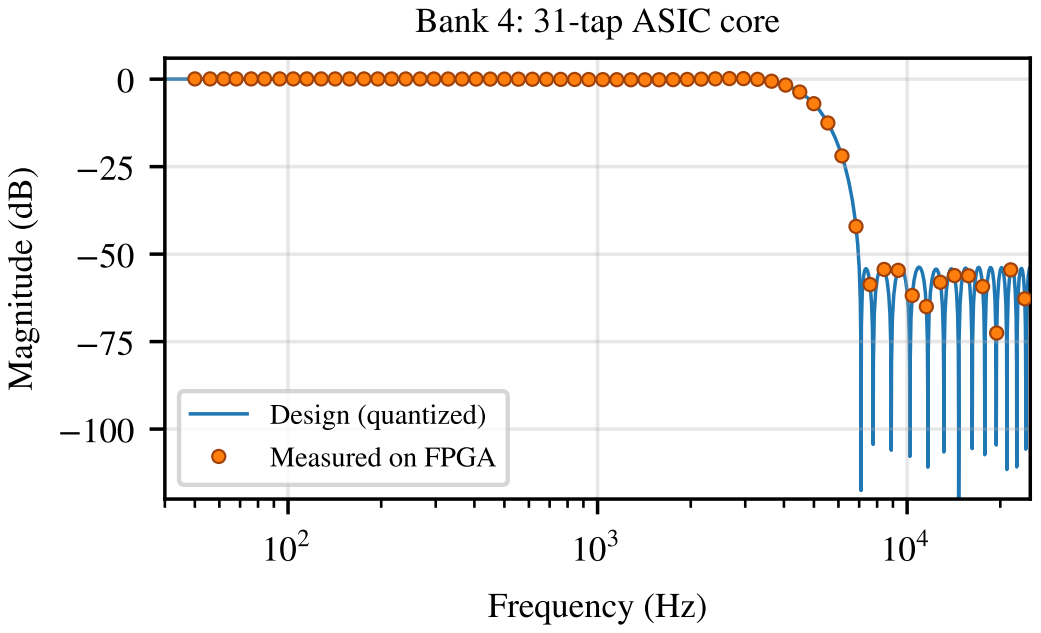
[picture p51: page 1]
Frequency (Hz); Magnitude (dB)

Bank 4: 31-tap ASIC core

Design (quantized)
Measured on FPGA
