saman-fuyal/fpga-audio-filter/docs/report/figs/chain_spectra.pdf

−150 −125 −100 −75 −50 −250

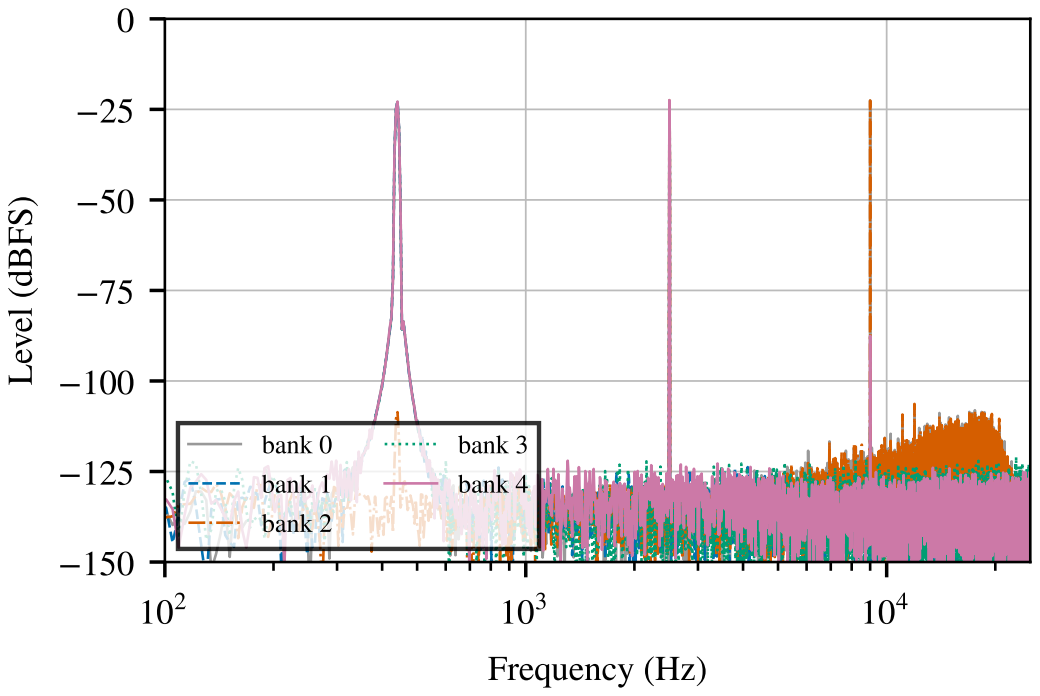
[picture p52: page 1]
Frequency (Hz); Level (dBFS); bank 0 bank 1 bank 2; bank 3 bank 4
