saman-fuyal/fpga-audio-filter/docs/report/figs/main_banks.pdf

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

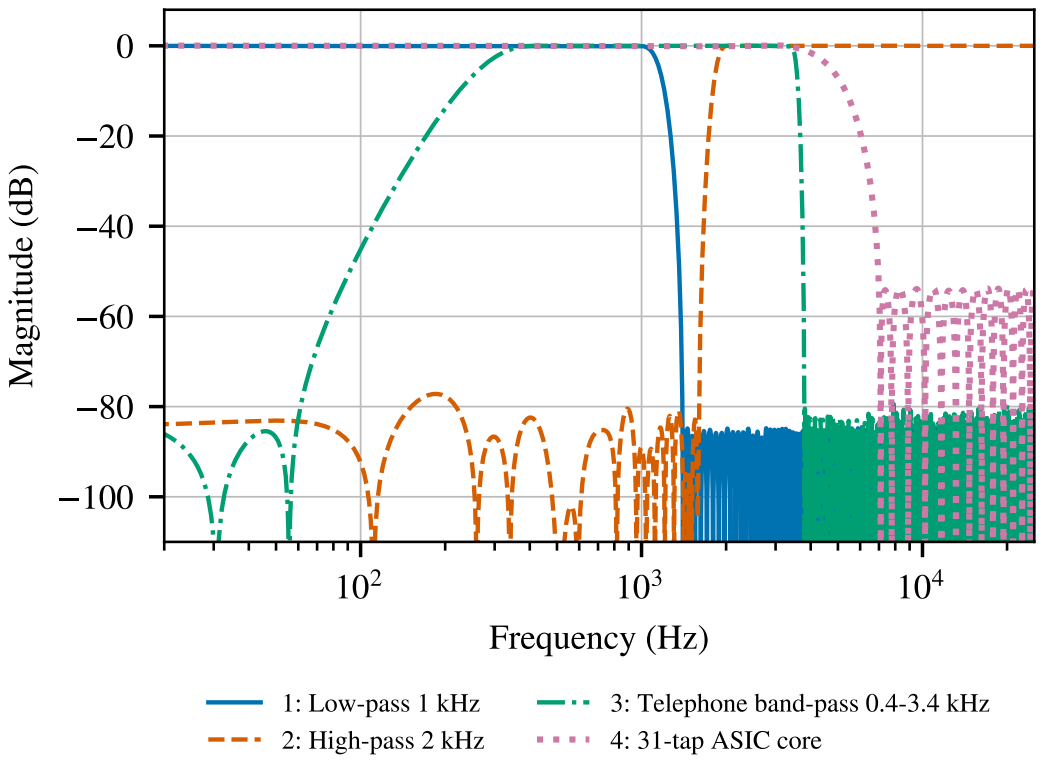
[picture p55: page 1]
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
