saman-fuyal/fpga-audio-filter/docs/report/figs/user/rtl_chain.pdf

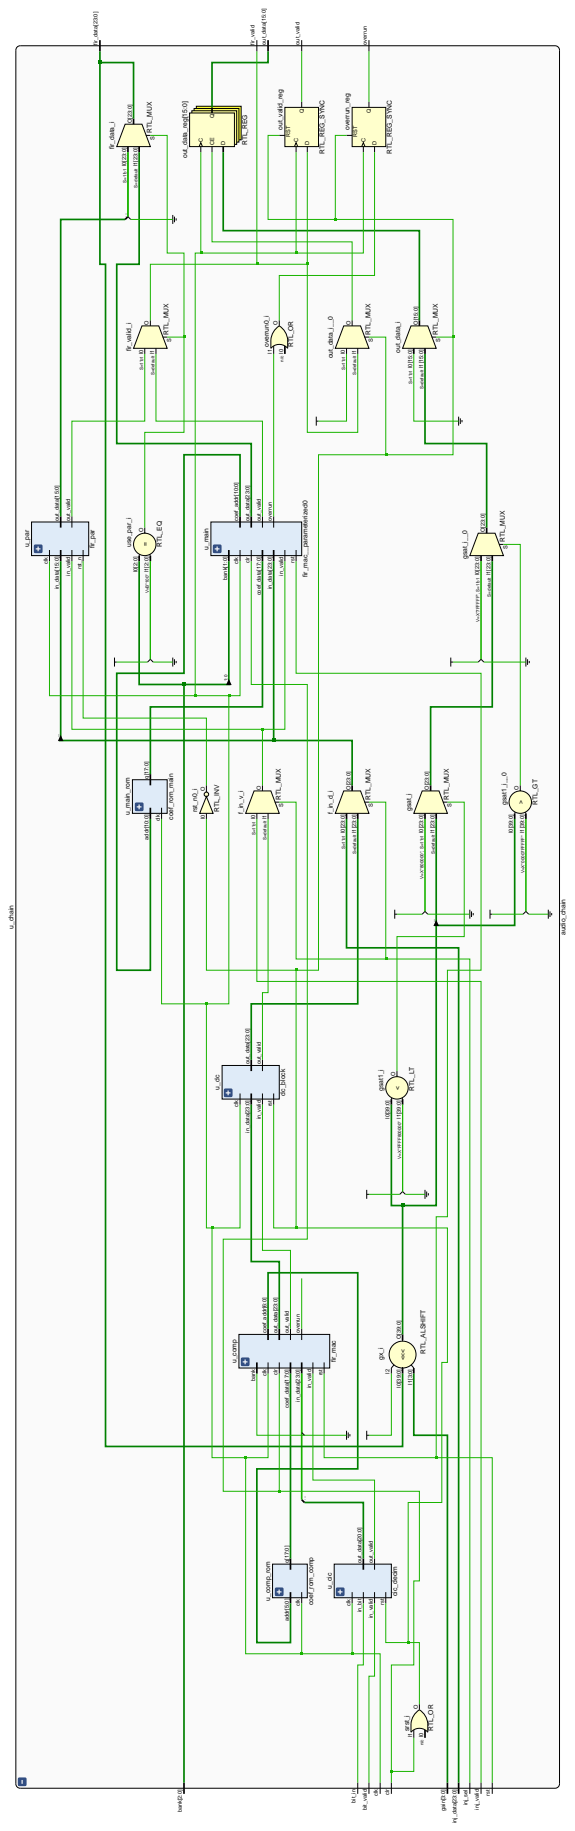
[picture p56: page 1]
u_chain; audio_chain; bit_in; bit_valid; clk; clr; fir_valid; inj_sel; inj_valid; out_valid; overrun; rst; bank[2:0]; fir_data[23:0]; gain[3:0]; inj_data[23:0]; out_data[15:0]; RTL_MUX; I1[23:0] S=default O[23:0]; I1 S=default; fir_data_i; I1[23:0] S=default O[23:0] fir_valid_i; gsat_i; gsat_i__0; I0[23:0] V=X"7FFFFF", S=1'b1; gsat1_i <RTL_LT O; I1[39:0] V=X"FFFF800000"; gsat1_i__0 >RTL_GT O; I1[39:0] V=X"00007FFFFF"; RTL_ALSHIFT; O[39:0] out_data_i; I1[15:0] S=default O[15:0]; out_data_i__0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
