saman-fuyal/fpga-audio-filter/docs/report/figs/user/rtl_top.pdf

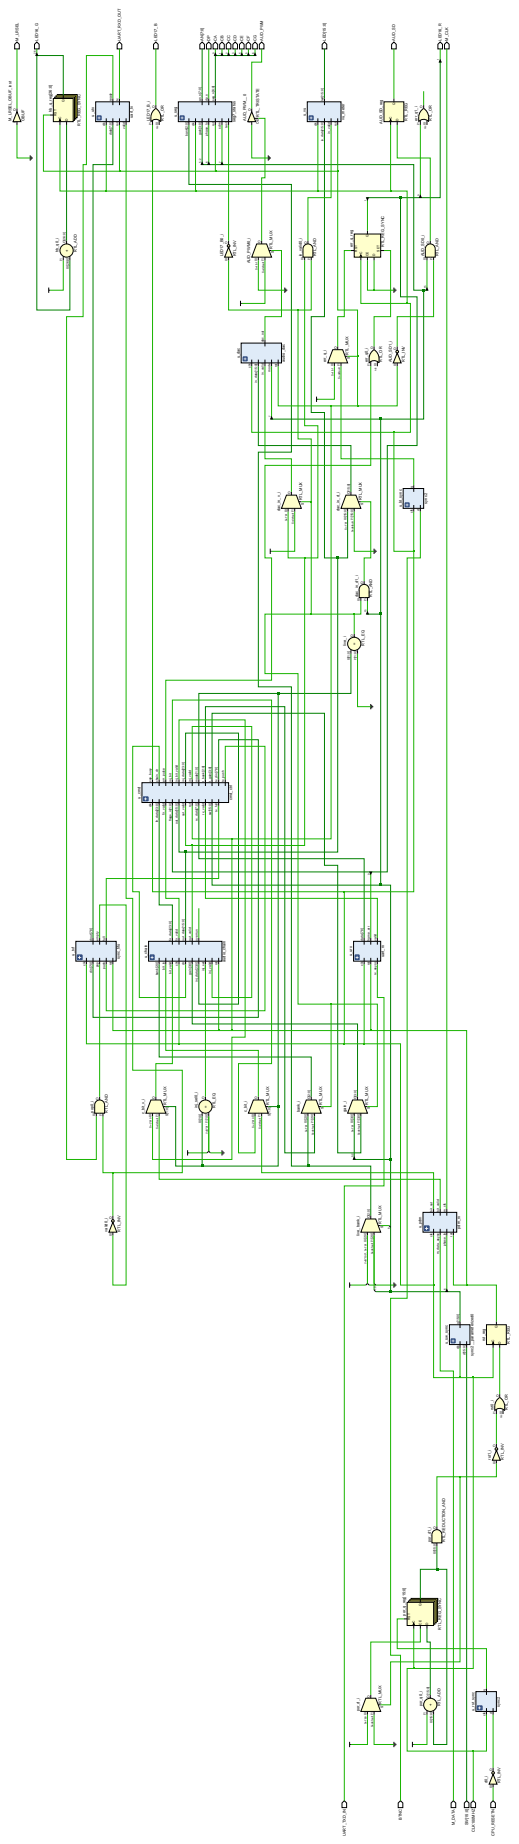
[picture p57: page 1]
UART_TXD_IN; BTNC; M_DATA; SW[15:0] CLK100MHZ; CPU_RESETN; d0_i RTL_INV I0 O; por_d_i; RTL_MUX; I1 S=default O S; por_q0_i +RTL_ADD; u_rst_sync; sync2; clkd q; por_q_reg[15:0]; RTL_REG_SYNC C CED Q; RST; por_d1_i RTL_REDUCTION_AND O I0[15:0]; rst1_i RTL_INV I0 O; rst0_i RTL_OR I1 O; u_sw_sync; sync2__parameterized0; clk d[15:0] q[15:0]; rst_reg; RTL_REG CD Q; valid0_i RTL_INV I0 O; live_bank_i; RTL_MUX S; I1[2:0] S=default O[2:0]; u_pdm; pdm_rx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
