saman-fuyal/fpga-audio-filter/fpga/constraints/nexys_a7.xdc

## Nexys A7-50T (also A7-100T) constraints for the real-time audio filter (top_nexys_a7)
## Pin lines copied verbatim from Digilent's official master file
## (github.com/Digilent/digilent-xdc, Nexys-A7-100T-Master.xdc). The 50T uses identical pins.

## ---------------------------------------------------------------- pins
set_property -dict { PACKAGE_PIN E3    IOSTANDARD LVCMOS33 } [get_ports { CLK100MHZ }]; #IO_L12P_T1_MRCC_35 Sch=clk100mhz
create_clock -add -name sys_clk_pin -period 10.00 -waveform {0 5} [get_ports {CLK100MHZ}];
set_property -dict { PACKAGE_PIN J15   IOSTANDARD LVCMOS33 } [get_ports { SW[0] }]; #IO_L24N_T3_RS0_15 Sch=sw[0]
set_property -dict { PACKAGE_PIN L16   IOSTANDARD LVCMOS33 } [get_ports { SW[1] }]; #IO_L3N_T0_DQS_EMCCLK_14 Sch=sw[1]
set_property -dict { PACKAGE_PIN M13   IOSTANDARD LVCMOS33 } [get_ports { SW[2] }]; #IO_L6N_T0_D08_VREF_14 Sch=sw[2]
set_property -dict { PACKAGE_PIN R15   IOSTANDARD LVCMOS33 } [get_ports { SW[3] }]; #IO_L13N_T2_MRCC_14 Sch=sw[3]
set_property -dict { PACKAGE_PIN R17   IOSTANDARD LVCMOS33 } [get_ports { SW[4] }]; #IO_L12N_T1_MRCC_14 Sch=sw[4]
set_property -dict { PACKAGE_PIN T18   IOSTANDARD LVCMOS33 } [get_ports { SW[5] }]; #IO_L7N_T1_D10_14 Sch=sw[5]
set_property -dict { PACKAGE_PIN U18   IOSTANDARD LVCMOS33 } [get_ports { SW[6] }]; #IO_L17N_T2_A13_D29_14 Sch=sw[6]
set_property -dict { PACKAGE_PIN R13   IOSTANDARD LVCMOS33 } [get_ports { SW[7] }]; #IO_L5N_T0_D07_14 Sch=sw[7]
set_property -dict { PACKAGE_PIN T8    IOSTANDARD LVCMOS18 } [get_ports { SW[8] }]; #IO_L24N_T3_34 Sch=sw[8]
set_property -dict { PACKAGE_PIN U8    IOSTANDARD LVCMOS18 } [get_ports { SW[9] }]; #IO_25_34 Sch=sw[9]
set_property -dict { PACKAGE_PIN R16   IOSTANDARD LVCMOS33 } [get_ports { SW[10] }]; #IO_L15P_T2_DQS_RDWR_B_14 Sch=sw[10]
set_property -dict { PACKAGE_PIN T13   IOSTANDARD LVCMOS33 } [get_ports { SW[11] }]; #IO_L23P_T3_A03_D19_14 Sch=sw[11]
set_property -dict { PACKAGE_PIN H6    IOSTANDARD LVCMOS33 } [get_ports { SW[12] }]; #IO_L24P_T3_35 Sch=sw[12]
set_property -dict { PACKAGE_PIN U12   IOSTANDARD LVCMOS33 } [get_ports { SW[13] }]; #IO_L20P_T3_A08_D24_14 Sch=sw[13]
set_property -dict { PACKAGE_PIN U11   IOSTANDARD LVCMOS33 } [get_ports { SW[14] }]; #IO_L19N_T3_A09_D25_VREF_14 Sch=sw[14]
set_property -dict { PACKAGE_PIN V10   IOSTANDARD LVCMOS33 } [get_ports { SW[15] }]; #IO_L21P_T3_DQS_14 Sch=sw[15]
set_property -dict { PACKAGE_PIN H17   IOSTANDARD LVCMOS33 } [get_ports { LED[0] }]; #IO_L18P_T2_A24_15 Sch=led[0]
set_property -dict { PACKAGE_PIN K15   IOSTANDARD LVCMOS33 } [get_ports { LED[1] }]; #IO_L24P_T3_RS1_15 Sch=led[1]
set_property -dict { PACKAGE_PIN J13   IOSTANDARD LVCMOS33 } [get_ports { LED[2] }]; #IO_L17N_T2_A25_15 Sch=led[2]
set_property -dict { PACKAGE_PIN N14   IOSTANDARD LVCMOS33 } [get_ports { LED[3] }]; #IO_L8P_T1_D11_14 Sch=led[3]
set_property -dict { PACKAGE_PIN R18   IOSTANDARD LVCMOS33 } [get_ports { LED[4] }]; #IO_L7P_T1_D09_14 Sch=led[4]
set_property -dict { PACKAGE_PIN V17   IOSTANDARD LVCMOS33 } [get_ports { LED[5] }]; #IO_L18N_T2_A11_D27_14 Sch=led[5]
set_property -dict { PACKAGE_PIN U17   IOSTANDARD LVCMOS33 } [get_ports { LED[6] }]; #IO_L17P_T2_A14_D30_14 Sch=led[6]
set_property -dict { PACKAGE_PIN U16   IOSTANDARD LVCMOS33 } [get_ports { LED[7] }]; #IO_L18P_T2_A12_D28_14 Sch=led[7]
set_property -dict { PACKAGE_PIN V16   IOSTANDARD LVCMOS33 } [get_ports { LED[8] }]; #IO_L16N_T2_A15_D31_14 Sch=led[8]
set_property -dict { PACKAGE_PIN T15   IOSTANDARD LVCMOS33 } [get_ports { LED[9] }]; #IO_L14N_T2_SRCC_14 Sch=led[9]
set_property -dict { PACKAGE_PIN U14   IOSTANDARD LVCMOS33 } [get_ports { LED[10] }]; #IO_L22P_T3_A05_D21_14 Sch=led[10]
set_property -dict { PACKAGE_PIN T16   IOSTANDARD LVCMOS33 } [get_ports { LED[11] }]; #IO_L15N_T2_DQS_DOUT_CSO_B_14 Sch=led[11]
set_property -dict { PACKAGE_PIN V15   IOSTANDARD LVCMOS33 } [get_ports { LED[12] }]; #IO_L16P_T2_CSI_B_14 Sch=led[12]
set_property -dict { PACKAGE_PIN V14   IOSTANDARD LVCMOS33 } [get_ports { LED[13] }]; #IO_L22N_T3_A04_D20_14 Sch=led[13]
set_property -dict { PACKAGE_PIN V12   IOSTANDARD LVCMOS33 } [get_ports { LED[14] }]; #IO_L20N_T3_A07_D23_14 Sch=led[14]
set_property -dict { PACKAGE_PIN V11   IOSTANDARD LVCMOS33 } [get_ports { LED[15] }]; #IO_L21N_T3_DQS_A06_D22_14 Sch=led[15]
set_property -dict { PACKAGE_PIN M16   IOSTANDARD LVCMOS33 } [get_ports { LED16_G }]; #IO_L10P_T1_D14_14 Sch=led16_g
set_property -dict { PACKAGE_PIN N15   IOSTANDARD LVCMOS33 } [get_ports { LED16_R }]; #IO_L11P_T1_SRCC_14 Sch=led16_r
set_property -dict { PACKAGE_PIN G14   IOSTANDARD LVCMOS33 } [get_ports { LED17_B }]; #IO_L15N_T2_DQS_ADV_B_15 Sch=led17_b
set_property -dict { PACKAGE_PIN T10   IOSTANDARD LVCMOS33 } [get_ports { CA }]; #IO_L24N_T3_A00_D16_14 Sch=ca
set_property -dict { PACKAGE_PIN R10   IOSTANDARD LVCMOS33 } [get_ports { CB }]; #IO_25_14 Sch=cb
set_property -dict { PACKAGE_PIN K16   IOSTANDARD LVCMOS33 } [get_ports { CC }]; #IO_25_15 Sch=cc
set_property -dict { PACKAGE_PIN K13   IOSTANDARD LVCMOS33 } [get_ports { CD }]; #IO_L17P_T2_A26_15 Sch=cd
set_property -dict { PACKAGE_PIN P15   IOSTANDARD LVCMOS33 } [get_ports { CE }]; #IO_L13P_T2_MRCC_14 Sch=ce
set_property -dict { PACKAGE_PIN T11   IOSTANDARD LVCMOS33 } [get_ports { CF }]; #IO_L19P_T3_A10_D26_14 Sch=cf
set_property -dict { PACKAGE_PIN L18   IOSTANDARD LVCMOS33 } [get_ports { CG }]; #IO_L4P_T0_D04_14 Sch=cg
set_property -dict { PACKAGE_PIN H15   IOSTANDARD LVCMOS33 } [get_ports { DP }]; #IO_L19N_T3_A21_VREF_15 Sch=dp
set_property -dict { PACKAGE_PIN J17   IOSTANDARD LVCMOS33 } [get_ports { AN[0] }]; #IO_L23P_T3_FOE_B_15 Sch=an[0]
set_property -dict { PACKAGE_PIN J18   IOSTANDARD LVCMOS33 } [get_ports { AN[1] }]; #IO_L23N_T3_FWE_B_15 Sch=an[1]
set_property -dict { PACKAGE_PIN T9    IOSTANDARD LVCMOS33 } [get_ports { AN[2] }]; #IO_L24P_T3_A01_D17_14 Sch=an[2]
set_property -dict { PACKAGE_PIN J14   IOSTANDARD LVCMOS33 } [get_ports { AN[3] }]; #IO_L19P_T3_A22_15 Sch=an[3]
set_property -dict { PACKAGE_PIN P14   IOSTANDARD LVCMOS33 } [get_ports { AN[4] }]; #IO_L8N_T1_D12_14 Sch=an[4]
set_property -dict { PACKAGE_PIN T14   IOSTANDARD LVCMOS33 } [get_ports { AN[5] }]; #IO_L14P_T2_SRCC_14 Sch=an[5]
set_property -dict { PACKAGE_PIN K2    IOSTANDARD LVCMOS33 } [get_ports { AN[6] }]; #IO_L23P_T3_35 Sch=an[6]
set_property -dict { PACKAGE_PIN U13   IOSTANDARD LVCMOS33 } [get_ports { AN[7] }]; #IO_L23N_T3_A02_D18_14 Sch=an[7]
set_property -dict { PACKAGE_PIN C12   IOSTANDARD LVCMOS33 } [get_ports { CPU_RESETN }]; #IO_L3P_T0_DQS_AD1P_15 Sch=cpu_resetn
set_property -dict { PACKAGE_PIN N17   IOSTANDARD LVCMOS33 } [get_ports { BTNC }]; #IO_L9P_T1_DQS_14 Sch=btnc
set_property -dict { PACKAGE_PIN J5    IOSTANDARD LVCMOS33 } [get_ports { M_CLK }]; #IO_25_35 Sch=m_clk
set_property -dict { PACKAGE_PIN H5    IOSTANDARD LVCMOS33 } [get_ports { M_DATA }]; #IO_L24N_T3_35 Sch=m_data
set_property -dict { PACKAGE_PIN F5    IOSTANDARD LVCMOS33 } [get_ports { M_LRSEL }]; #IO_0_35 Sch=m_lrsel
set_property -dict { PACKAGE_PIN A11   IOSTANDARD LVCMOS33 } [get_ports { AUD_PWM }]; #IO_L4N_T0_15 Sch=aud_pwm
set_property -dict { PACKAGE_PIN D12   IOSTANDARD LVCMOS33 } [get_ports { AUD_SD }]; #IO_L6P_T0_15 Sch=aud_sd
set_property -dict { PACKAGE_PIN C4    IOSTANDARD LVCMOS33 } [get_ports { UART_TXD_IN }]; #IO_L7P_T1_AD6P_35 Sch=uart_txd_in
set_property -dict { PACKAGE_PIN D4    IOSTANDARD LVCMOS33 } [get_ports { UART_RXD_OUT }]; #IO_L11N_T1_SRCC_35 Sch=uart_rxd_out

## ---------------------------------------------------------------- configuration
set_property CFGBVS VCCO [current_design]
set_property CONFIG_VOLTAGE 3.3 [current_design]
set_property BITSTREAM.GENERAL.COMPRESS TRUE [current_design]
set_property BITSTREAM.CONFIG.SPI_BUSWIDTH 4 [current_design]
set_property BITSTREAM.CONFIG.CONFIGRATE 33 [current_design]

## ---------------------------------------------------------------- I/O timing
## The whole design runs on the single 100 MHz clock. Every asynchronous input goes through
## a 2-flop synchronizer (sync2, ASYNC_REG) so it has no static-timing relationship with
## the clock; the outputs drive LEDs, displays, a 1 Mbaud UART and the 2.5 MHz microphone
## clock, all of which tolerate many ns of skew. These are therefore declared false paths
## instead of constraining them with fictitious board delays.
##
## M_DATA timing is guaranteed by design, not by STA: it is sampled ~150 ns after the M_CLK
## edge that launches it (half period 200 ns), see rtl/pdm_rx.v and paper Sec. IV-B.
set_false_path -from [get_ports {SW[*] BTNC CPU_RESETN M_DATA UART_TXD_IN}]
set_false_path -to   [get_ports {LED[*] LED16_R LED16_G LED17_B CA CB CC CD CE CF CG DP AN[*]}]
set_false_path -to   [get_ports {M_CLK M_LRSEL AUD_PWM AUD_SD UART_RXD_OUT}]
## (the M_CLK flop is packed into the I/O tile via an IOB attribute in rtl/pdm_rx.v)
